xonik/xm8-panelized/ordered-march-1st-2025/AS3364 DG412 bus mixer v1.4-4-layer-brd.md

# AS3364 DG412 bus mixer v1.4-4-layer

### Board top
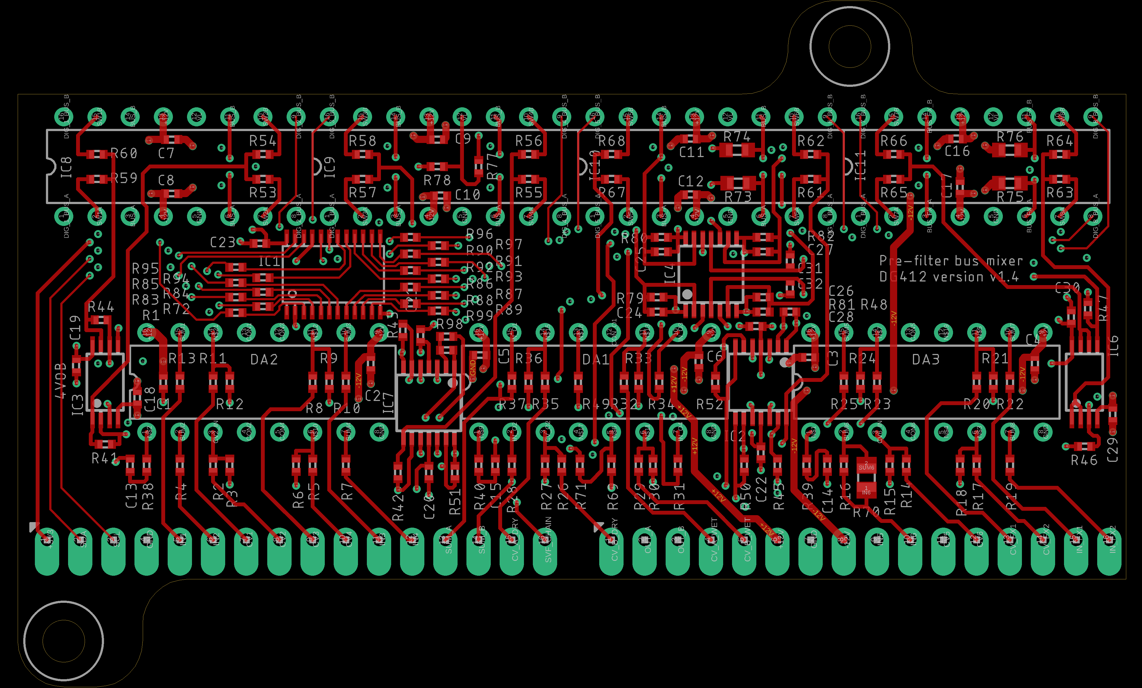
[picture p1: ordered-march-1st-2025/AS3364 DG412 bus mixer v1.4-4-layer-brd-top.png]
Top side

### Board bottom
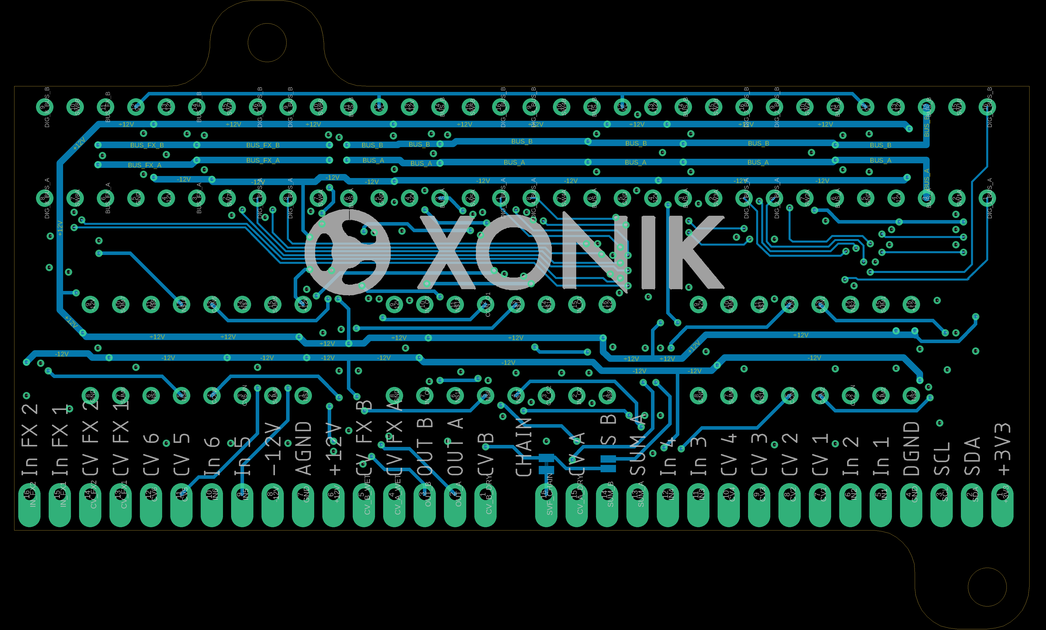
[picture p2: ordered-march-1st-2025/AS3364 DG412 bus mixer v1.4-4-layer-brd-bottom.png]
Bottom side
