xonik/xm8-panelized/ordered-2024/Filter boards jp6 v2.0 moog v1.2.1 - v1.0-brd.md

# Filter boards jp6 v2.0 moog v1.2.1 - v1.0

### Board top
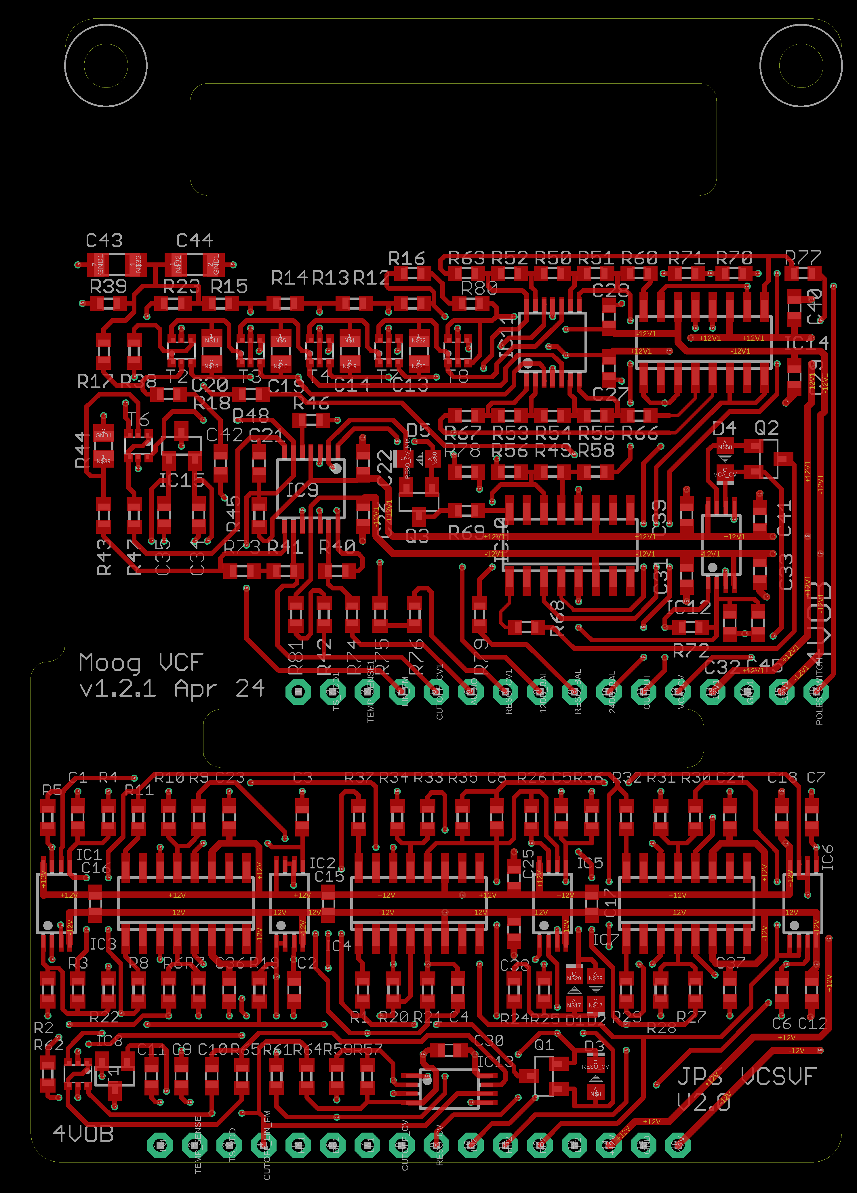
[picture p3: ordered-2024/Filter boards jp6 v2.0 moog v1.2.1 - v1.0-brd-top.png]
Top side

### Board bottom
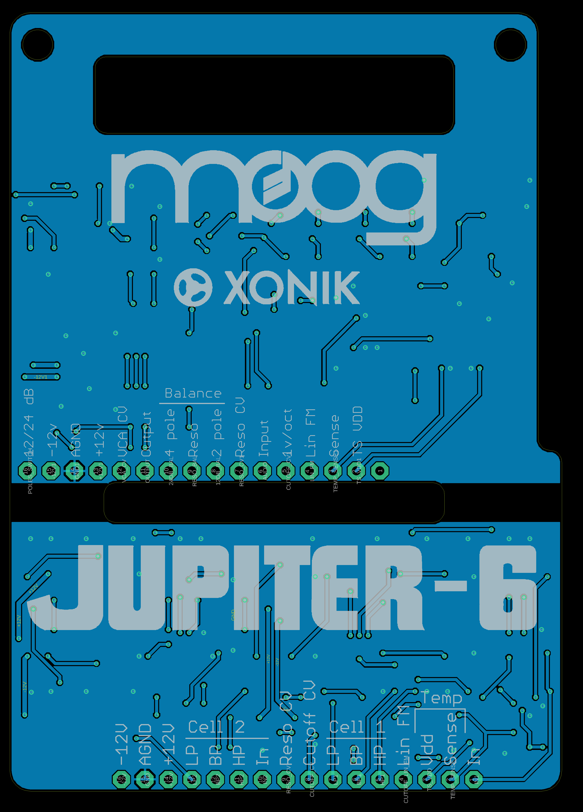
[picture p4: ordered-2024/Filter boards jp6 v2.0 moog v1.2.1 - v1.0-brd-bottom.png]
Bottom side
