xonik/xm8-panelized/ordered-2024/Waveshapers v2.2 for voice board v1.1.1 - v1.0-brd.md

# Waveshapers v2.2 for voice board v1.1.1 - v1.0

### Board top
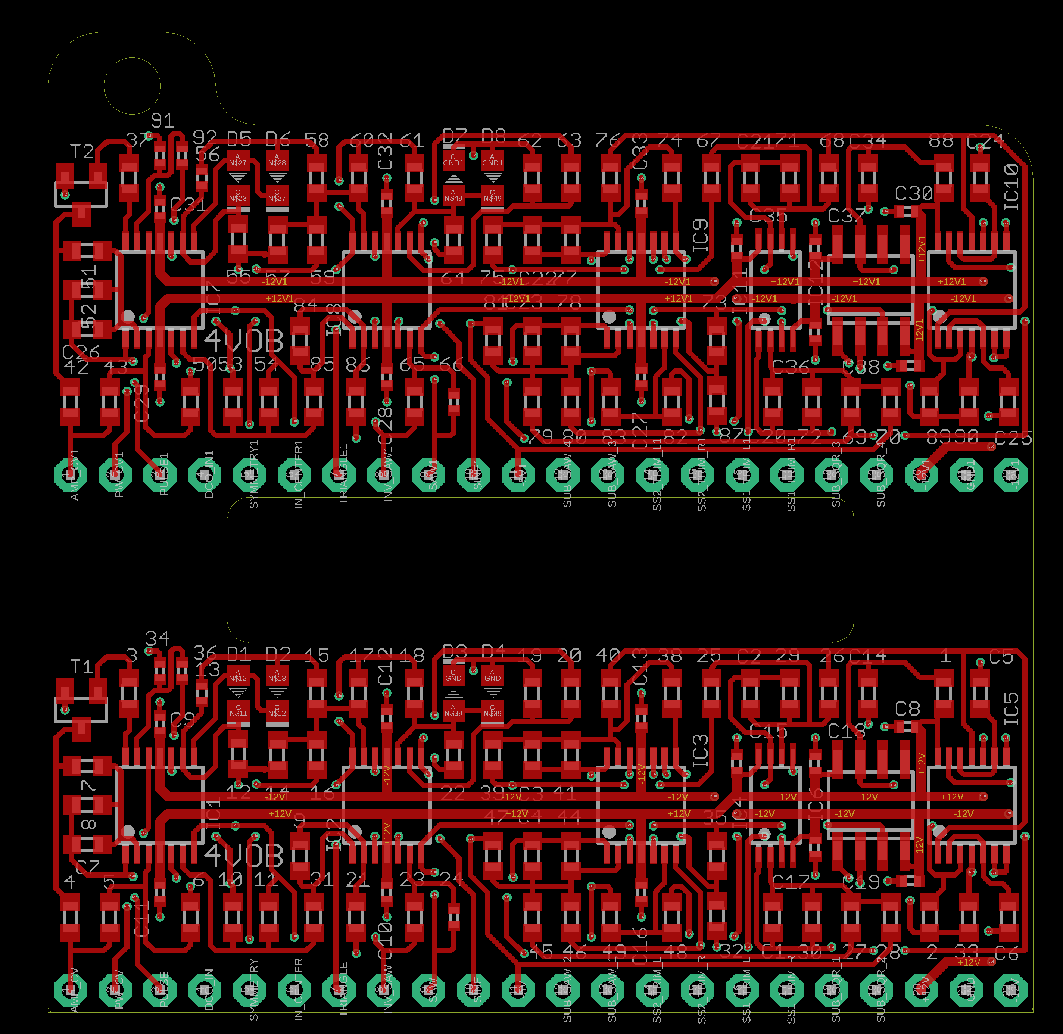
[picture p5: ordered-2024/Waveshapers v2.2 for voice board v1.1.1 - v1.0-brd-top.png]
Top side

### Board bottom
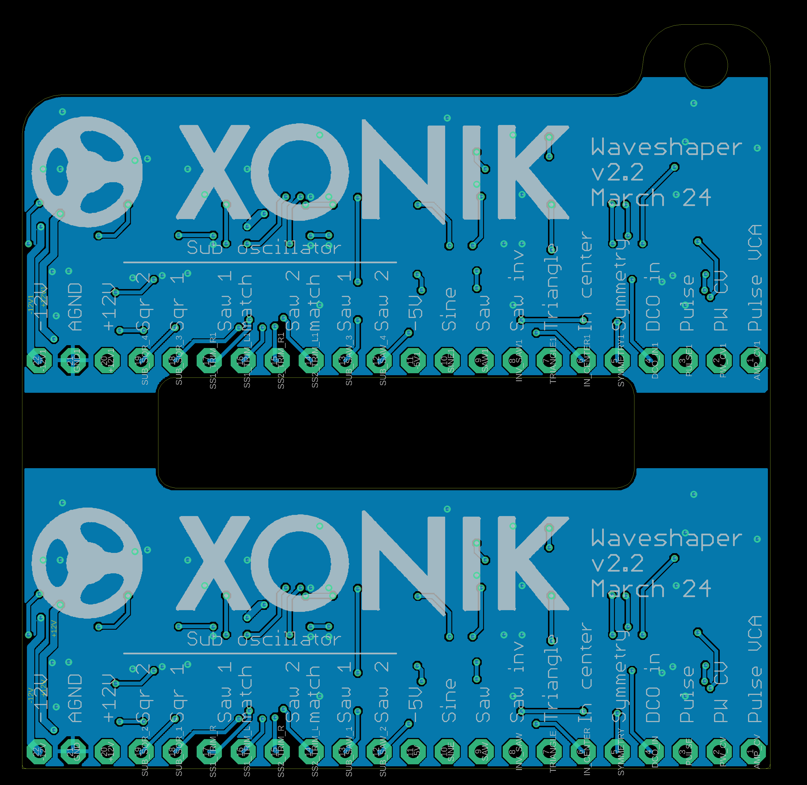
[picture p6: ordered-2024/Waveshapers v2.2 for voice board v1.1.1 - v1.0-brd-bottom.png]
Bottom side
