xonik/xm8-panelized/ordered-march-1st-2025/button_breakout_v1.0_top_bom_populated.csv

Comment | Designator | Footprint | LCSC Part #
MA08-2J | X1 X2 X3 X4 | MA08-2J | C5383108
CONN-IDC-10PS | IDC IDC1 IDC2 IDC3 | CONN-IDC10P-S | C429962
