xonik/xm8-panelized/ordered-march-1st-2025/AS3364 DG412 bus mixer v1.4-4-layer.brd

## EAGLE design ordered-march-1st-2025/AS3364 DG412 bus mixer v1.4-4-layer.brd (2025-03-01)

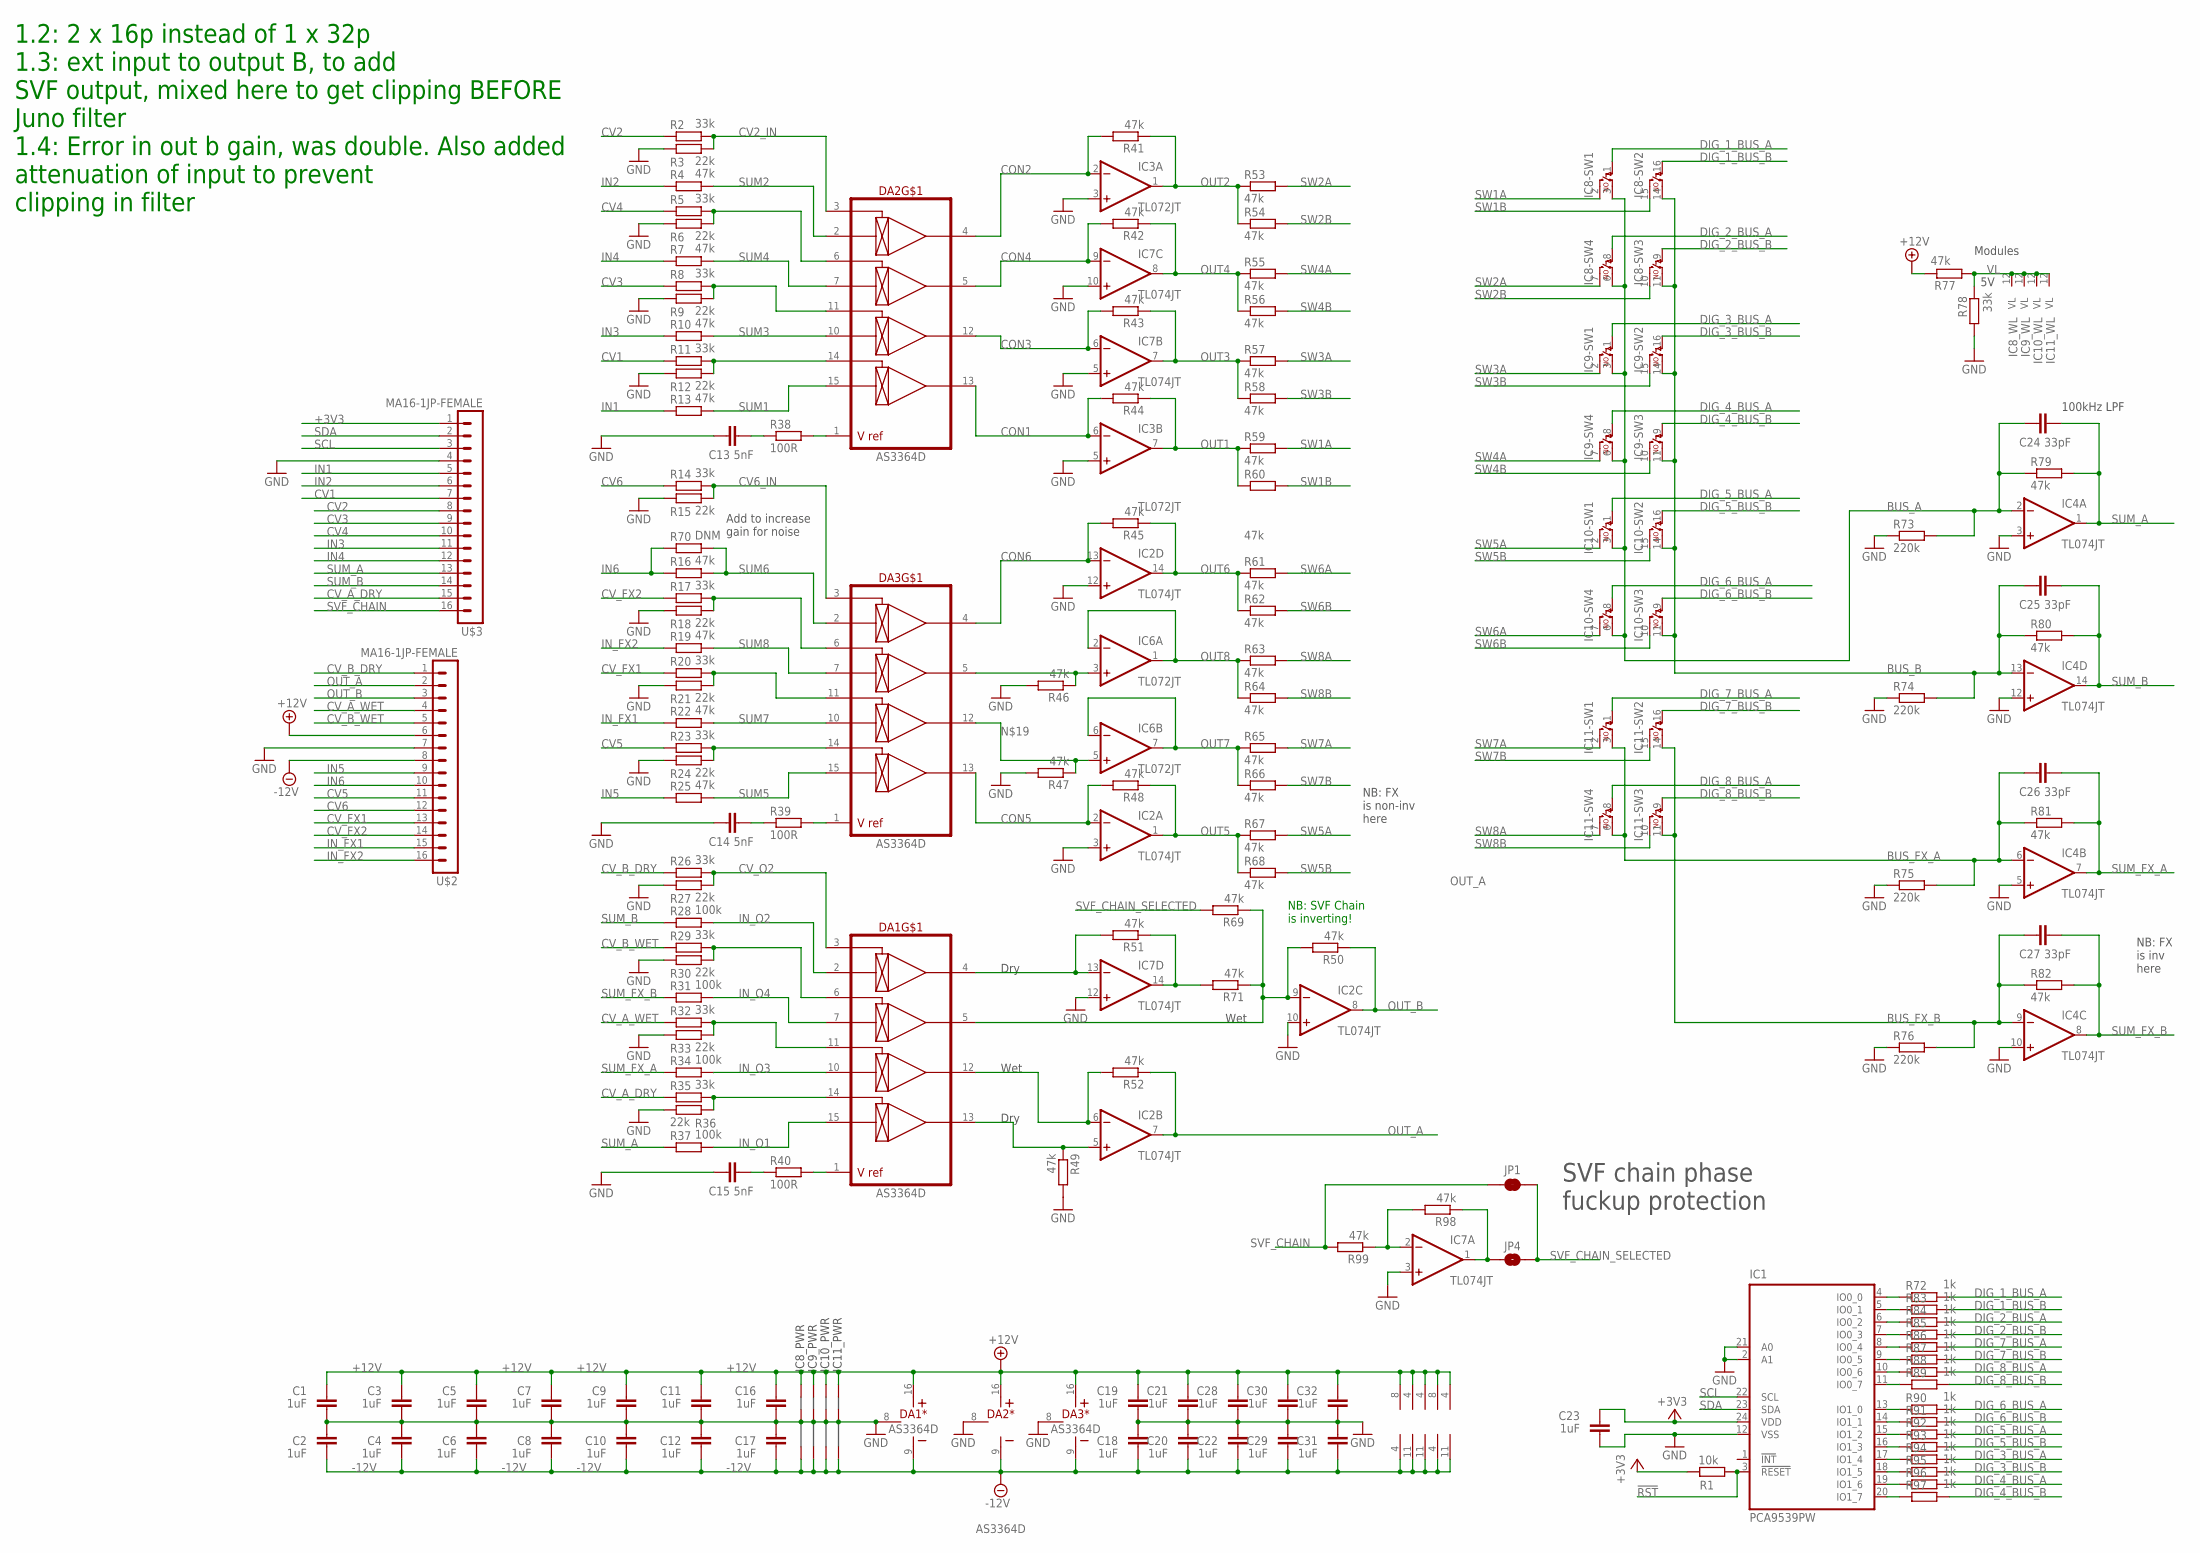
[picture p7: schematic AS3364 DG412 bus mixer v1.4-4-layer.sch]

Parts:
C1, C2, C3, C4, C5, C6, C7, C8, C9, C10, C11, C12, C16, C17, C18, C19, C20, C21, C22, C23, C28, C29, C30, C31, C32: 1uF; C0402-J
C13, C14, C15: 5nF; C0402-J
C24, C25, C26, C27: 33pF; C0402-J
DA1, DA2, DA3: AS3364D; DIL16J
IC1: PCA9539PW; TSSOP24J
IC2, IC4, IC7: TL074JT; TSSOP14J
IC3, IC6: TL072JT; TSSOP8J
IC8, IC9, IC10, IC11: DG412-J; DIL16J
JP1: JUMPER-SMT_2_NC_TRACE_SILK-DNM; SMT-JUMPER_2_NC_TRACE_SILK
JP4: JUMPER-SMT_2_NO_SILK-DNM; SMT-JUMPER_2_NO_SILK
R1: 10k; R0402
R2, R5, R8, R11, R14, R17, R20, R23, R26, R29, R32, R35, R78: 33k; R0402
R3, R6, R9, R12, R15, R18, R21, R24, R27, R30, R33, R36: 22k; R0402
R4, R7, R10, R13, R16, R19, R22, R25, R41, R42, R43, R44, R45, R46, R47, R48, R49, R50, R51, R52, R53, R54, R55, R56, R57, R58, R59, R60, R61, R62, R63, R64, R65, R66, R67, R68, R69, R71, R77, R79, R80, R81, R82, R98, R99: 47k; R0402
R28, R31, R34, R37: 100k; R0402
R38, R39, R40: 100R; R0402
R70: DNM; R0805
R72, R83, R84, R85, R86, R87, R88, R89, R90, R91, R92, R93, R94, R95, R96, R97: 1k; R0402
R73, R74, R75, R76: 220k; R0603
U$2, U$3: MA16-1JP-FEMALE; SIP-PIN16-1J

Connections:
!RST: IC1.3 (!RESET), R1.2
+3V3: C23.2, IC1.24 (VDD), R1.1, U$3.1
+12V: C1.2, C3.2, C5.2, C7.2, C9.2, C11.2, C16.2, C19.2, C21.2, C28.2, C30.2, C32.2, DA1.16 (V+), DA2.16 (V+), DA3.16 (V+), IC2.4 (V+), IC3.8 (V+), IC4.4 (V+), IC6.8 (V+), IC7.4 (V+), IC8.13 (+15V), IC9.13 (+15V), IC10.13 (+15V), IC11.13 (+15V), R77.1, U$2.6
-12V: C2.1, C4.1, C6.1, C8.1, C10.1, C12.1, C17.1, C18.1, C20.1, C22.1, C29.1, C31.1, DA1.9 (V-), DA2.9 (V-), DA3.9 (V-), IC2.11 (V-), IC3.4 (V-), IC4.11 (V-), IC6.4 (V-), IC7.11 (V-), IC8.4 (-15V), IC9.4 (-15V), IC10.4 (-15V), IC11.4 (-15V), U$2.8
BUS_A: C24.1, IC4.2 (-IN), IC8.3 (S), IC8.6 (S), IC9.3 (S), IC9.6 (S), IC10.3 (S), IC10.6 (S), R73.2, R79.1
BUS_B: C25.1, IC4.13 (-IN), IC8.11 (S), IC8.14 (S), IC9.11 (S), IC9.14 (S), IC10.11 (S), IC10.14 (S), R74.2, R80.1
BUS_FX_A: C26.1, IC4.6 (-IN), IC11.3 (S), IC11.6 (S), R75.2, R81.1
BUS_FX_B: C27.1, IC4.9 (-IN), IC11.11 (S), IC11.14 (S), R76.2, R82.1
CON1: DA2.13 (OUT4), IC3.6 (-IN), R44.2
CON2: DA2.4 (OUT1), IC3.2 (-IN), R41.2
CON3: DA2.12 (OUT3), IC7.6 (-IN), R43.2
CON4: DA2.5 (OUT2), IC7.9 (-IN), R42.2
CON5: DA3.13 (OUT4), IC2.2 (-IN), R48.2
CON6: DA3.4 (OUT1), IC2.13 (-IN), R45.2
CON_O1: DA1.12 (OUT3), IC2.6 (-IN), R52.2
CV1: R11.1, U$3.7
CV2: R2.1, U$3.8
CV2_IN: DA2.3 (CV1), R2.2, R3.2
CV3: R8.1, U$3.9
CV4: R5.1, U$3.10
CV5: R23.1, U$2.11
CV6: R14.1, U$2.12
CV6_IN: DA3.3 (CV1), R14.2, R15.2
CV_A_DRY: R35.1, U$3.15
CV_A_WET: R32.1, U$2.4
CV_B_DRY: R26.1, U$2.1
CV_B_WET: R29.1, U$2.5
CV_FX1: R20.1, U$2.13
CV_FX2: R17.1, U$2.14
CV_O2: DA1.3 (CV1), R26.2, R27.2
DIG_1_BUS_A: IC8.1 (C), R72.2
DIG_1_BUS_B: IC8.16 (C), R83.2
DIG_2_BUS_A: IC8.8 (C), R84.2
DIG_2_BUS_B: IC8.9 (C), R85.2
DIG_3_BUS_A: IC9.1 (C), R94.2
DIG_3_BUS_B: IC9.16 (C), R95.2
DIG_4_BUS_A: IC9.8 (C), R96.2
DIG_4_BUS_B: IC9.9 (C), R97.2
DIG_5_BUS_A: IC10.1 (C), R92.2
DIG_5_BUS_B: IC10.16 (C), R93.2
DIG_6_BUS_A: IC10.8 (C), R90.2
DIG_6_BUS_B: IC10.9 (C), R91.2
DIG_7_BUS_A: IC11.1 (C), R86.2
DIG_7_BUS_B: IC11.16 (C), R87.2
DIG_8_BUS_A: IC11.8 (C), R88.2
DIG_8_BUS_B: IC11.9 (C), R89.2
GND: C1.1, C2.2, C3.1, C4.2, C5.1, C6.2, C7.1, C8.2, C9.1, C10.2, C11.1, C12.2, C13.1, C14.1, C15.1, C16.1, C17.2, C18.2, C19.1, C20.2, C21.1, C22.2, C23.1, C28.1, C29.2, C30.1, C31.2, C32.1, DA1.8 (GND), DA2.8 (GND), DA3.8 (GND), IC1.2 (A1), IC1.12 (VSS), IC1.21 (A0), IC2.3 (+IN), IC2.10 (+IN), IC2.12 (+IN), IC3.3 (+IN), IC3.5 (+IN), IC4.3 (+IN), IC4.5 (+IN), IC4.10 (+IN), IC4.12 (+IN), IC7.3 (+IN), IC7.5 (+IN), IC7.10 (+IN), IC7.12 (+IN), IC8.5 (AGND), IC9.5 (AGND), IC10.5 (AGND), IC11.5 (AGND), R3.1, R6.1, R9.1, R12.1, R15.1, R18.1, R21.1, R24.1, R27.1, R30.1, R33.1, R36.1, R46.2, R47.2, R49.2, R73.1, R74.1, R75.1, R76.1, R78.2, U$2.7, U$3.4
IN1: R13.1, U$3.5
IN2: R4.1, U$3.6
IN3: R10.1, U$3.11
IN4: R7.1, U$3.12
IN5: R25.1, U$2.9
IN6: R16.1, R70.1, U$2.10
IN_FX1: R22.1, U$2.15
IN_FX2: R19.1, U$2.16
IN_O1: DA1.15 (IN4), R37.2
IN_O2: DA1.2 (IN1), R28.2
IN_O3: DA1.10 (IN3), R34.2
IN_O4: DA1.7 (IN2), R31.2
unnamed: DA3.1 (VREF), R39.2
unnamed: DA2.1 (VREF), R38.2
unnamed: DA3.6 (CV2), R17.2, R18.2
unnamed: DA3.5 (OUT2), IC6.3 (+IN), R46.1
unnamed: DA3.11 (CV3), R20.2, R21.2
unnamed: DA1.5 (OUT2), IC2.9 (-IN), R50.2, R69.1, R71.1
unnamed: DA3.14 (CV4), R23.2, R24.2
unnamed: C14.2, R39.1
unnamed: DA1.1 (VREF), R40.2
unnamed: DA2.6 (CV2), R5.2, R6.2
unnamed: DA1.6 (CV2), R29.2, R30.2
unnamed: DA2.11 (CV3), R8.2, R9.2
unnamed: DA1.11 (CV3), R32.2, R33.2
unnamed: C13.2, R38.1
unnamed: DA1.14 (CV4), R35.2, R36.2
unnamed: C15.2, R40.1
unnamed: DA1.4 (OUT1), IC7.13 (-IN), R51.2
unnamed: DA1.13 (OUT4), IC2.5 (+IN), R49.1
unnamed: DA3.12 (OUT3), IC6.5 (+IN), R47.1
unnamed: IC7.14 (OUT), R51.1, R71.2
unnamed: DA2.14 (CV4), R11.2, R12.2
unnamed: IC7.1 (OUT), JP4.1, R98.1
unnamed: IC1.4 (IO0_0), R72.1
unnamed: IC1.5 (IO0_1), R83.1
unnamed: IC1.6 (IO0_2), R84.1
unnamed: IC1.7 (IO0_3), R85.1
unnamed: IC1.8 (IO0_4), R86.1
unnamed: IC1.9 (IO0_5), R87.1
unnamed: IC1.10 (IO0_6), R88.1
unnamed: IC1.11 (IO0_7), R89.1
unnamed: IC1.13 (IO1_0), R90.1
unnamed: IC1.14 (IO1_1), R91.1
unnamed: IC1.15 (IO1_2), R92.1
unnamed: IC1.16 (IO1_3), R93.1
unnamed: IC1.17 (IO1_4), R94.1
unnamed: IC1.18 (IO1_5), R95.1
unnamed: IC1.19 (IO1_6), R96.1
unnamed: IC1.20 (IO1_7), R97.1
unnamed: IC7.2 (-IN), R98.2, R99.1
OUT1: IC3.7 (OUT), R44.1, R59.1, R60.1
OUT2: IC3.1 (OUT), R41.1, R53.1, R54.1
OUT3: IC7.7 (OUT), R43.1, R57.1, R58.1
OUT4: IC7.8 (OUT), R42.1, R55.1, R56.1
OUT5: IC2.1 (OUT), R48.1, R67.1, R68.1
OUT6: IC2.14 (OUT), R45.1, R61.1, R62.1
OUT7: IC6.6 (-IN), IC6.7 (OUT), R65.1, R66.1
OUT8: IC6.1 (OUT), IC6.2 (-IN), R63.1, R64.1
OUT_A: IC2.7 (OUT), R52.1, U$2.2
OUT_B: IC2.8 (OUT), R50.1, U$2.3
SCL: IC1.22 (SCL), U$3.3
SDA: IC1.23 (SDA), U$3.2
SUM1: DA2.15 (IN4), R13.2
SUM2: DA2.2 (IN1), R4.2
SUM3: DA2.10 (IN3), R10.2
SUM4: DA2.7 (IN2), R7.2
SUM5: DA3.15 (IN4), R25.2
SUM6: DA3.2 (IN1), R16.2, R70.2
SUM7: DA3.10 (IN3), R22.2
SUM8: DA3.7 (IN2), R19.2
SUM_A: C24.2, IC4.1 (OUT), R37.1, R79.2, U$3.13
SUM_B: C25.2, IC4.14 (OUT), R28.1, R80.2, U$3.14
SUM_FX_A: C26.2, IC4.7 (OUT), R34.1, R81.2
SUM_FX_B: C27.2, IC4.8 (OUT), R31.1, R82.2
SVF_CHAIN: JP1.1, R99.2, U$3.16
SVF_CHAIN_SELECTED: JP1.2, JP4.2, R69.2
SW1A: IC8.2 (D), R59.2
SW1B: IC8.15 (D), R60.2
SW2A: IC8.7 (D), R53.2
SW2B: IC8.10 (D), R54.2
SW3A: IC9.2 (D), R57.2
SW3B: IC9.15 (D), R58.2
SW4A: IC9.7 (D), R55.2
SW4B: IC9.10 (D), R56.2
SW5A: IC10.2 (D), R67.2
SW5B: IC10.15 (D), R68.2
SW6A: IC10.7 (D), R61.2
SW6B: IC10.10 (D), R62.2
SW7A: IC11.2 (D), R65.2
SW7B: IC11.15 (D), R66.2
SW8A: IC11.7 (D), R63.2
SW8B: IC11.10 (D), R64.2
VL: IC8.12 (VL), IC9.12 (VL), IC10.12 (VL), IC11.12 (VL), R77.2, R78.1

Notes on the sheet:
SVF chain phase fuckup protection
Modules
100kHz LPF
Wet
Dry
NB: FX is non-inv here
NB: FX is inv here
1.2: 2 x 16p instead of 1 x 32p 1.3: ext input to output B, to add SVF output, mixed here to get clipping BEFORE Juno filter 1.4: Error in out b gain, was double. Also added attenuation of input to prevent clipping in filter
NB: SVF Chain is inverting!
Add to increase gain for noise

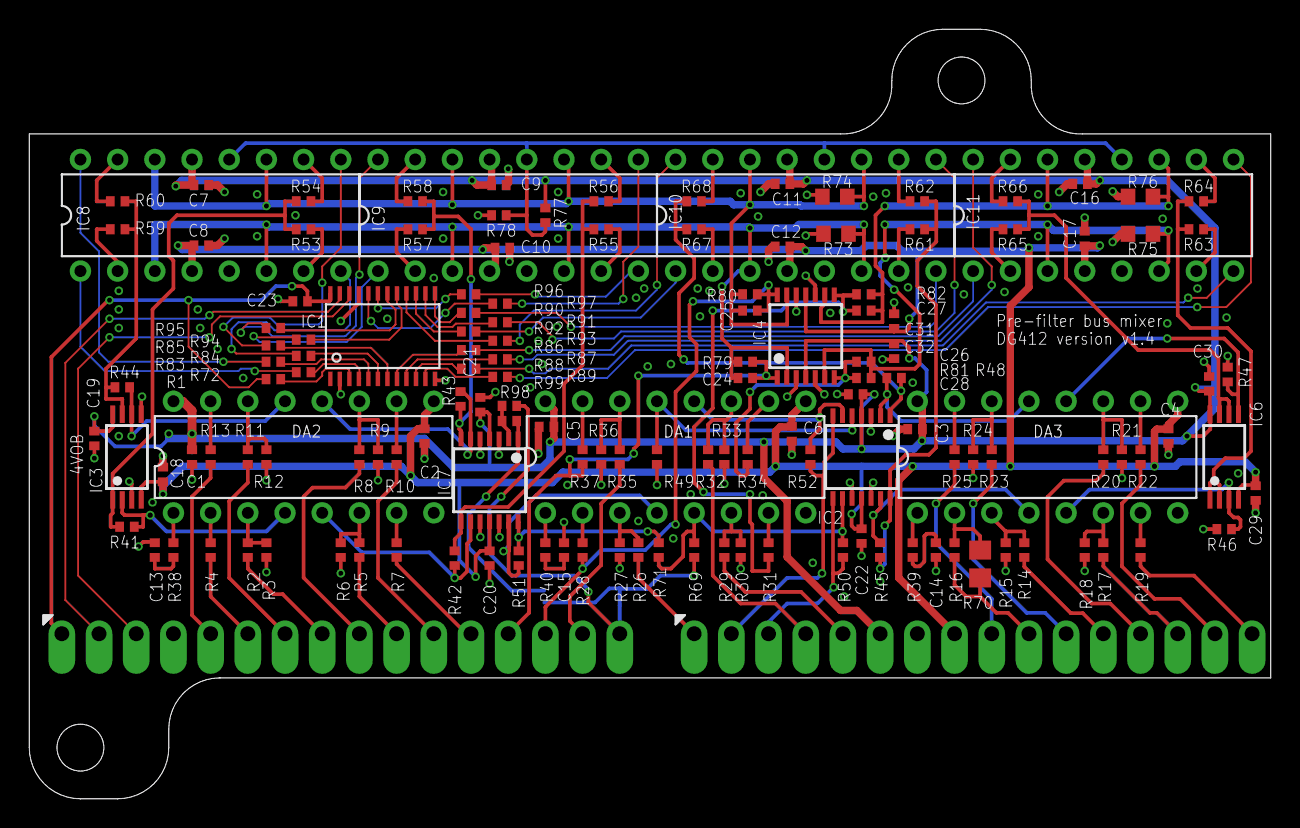
[picture p8: board AS3364 DG412 bus mixer v1.4-4-layer.brd from above]

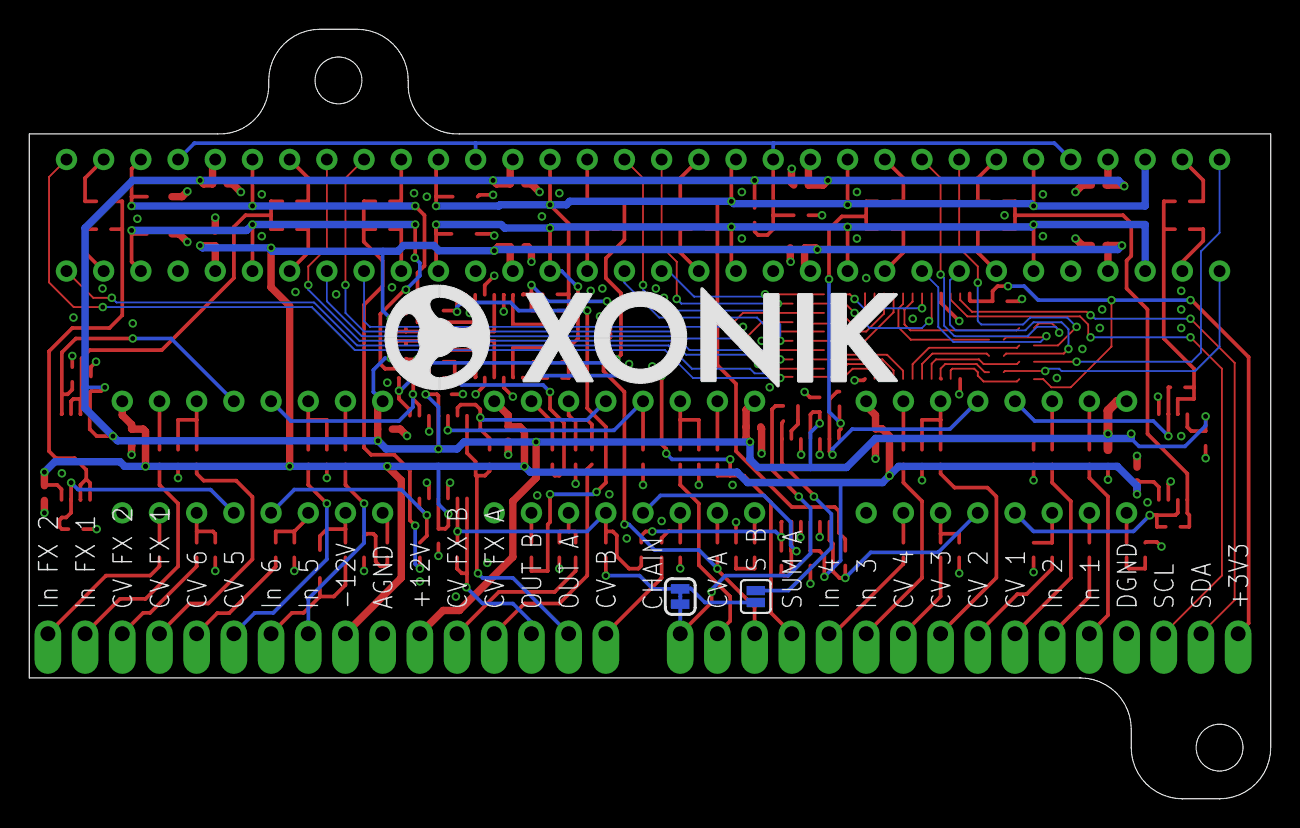
[picture p9: board AS3364 DG412 bus mixer v1.4-4-layer.brd from below]

Board: 4 copper layers, 84.8 x 52.5 mm, 149 parts (3 on the bottom side), 141 nets.

Other parts of the board:
U$1: XONIK_LOGO_35
