xonik/xm8-panelized/ordered-march-1st-2025/small-fix-cards-panelized.brd

## EAGLE design ordered-march-1st-2025/small-fix-cards-panelized.brd (2025-03-01)

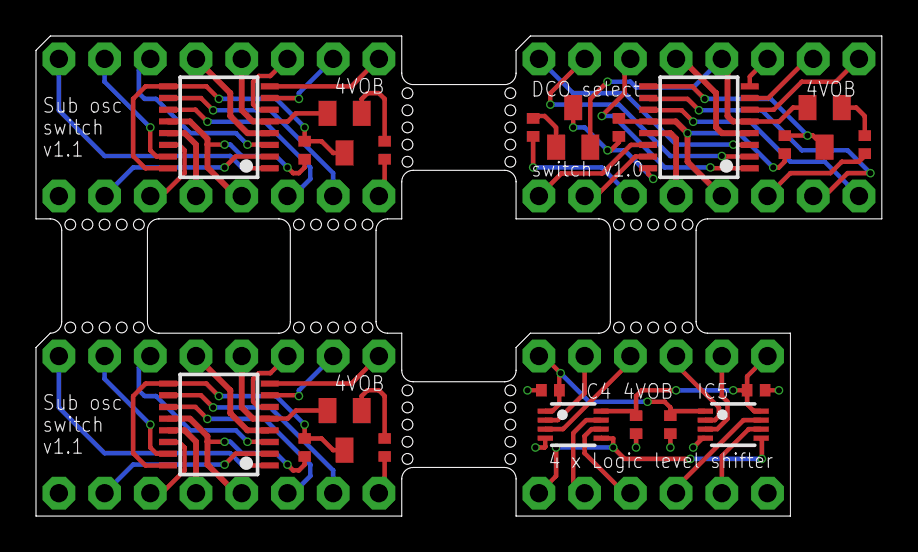
[picture p10: board small-fix-cards-panelized.brd from above]

Board: 2 copper layers, 47.0 x 26.7 mm, 29 parts (0 on the bottom side), 66 nets.

Parts:
C1, C2, C3, C4: 1uF; C0402-J
IC1, IC2, IC3: DG412-JT; TSSOP16J
IC4, IC5: SN74LVC2T45; VSSOP8J
R1, R2, R5, R6: 10k; R0402
R3, R4, R7, R8: 470R; R0402
T1, T2, T3, T4: 2n3904; SOT23-BEC
X1, X2, X3, X4, X5, X6: ROUND-IC-PIN; MA08N-1J
X7, X8: MA06-1JN; MA06N-1J

Connections:
1_A_SUB_WAVE: IC2.1, X1.1
1_A_SUB_WAVE1: IC1.1, X3.1
1_OSC_B_OUT: IC3.3, X5.1
2_SSA1A: IC2.15, X1.2
2_SSA1A1: IC1.15, X3.2
2_WAVE_B_OUT: IC3.2, X5.2
3_A_SUB_1: IC2.3, X1.3
3_A_SUB_2: IC1.3, X3.3
3_B_MODE: IC3.1, X5.3
6_A_MODE: IC3.8, X5.6
6_A_SUB_1: IC1.6, X3.6
6_A_SUB_2: IC2.6, X1.6
7_SSQ2A: IC2.7, X1.7
7_SSQ2A1: IC1.7, X3.7
7_WAVE_A_OUT: IC3.7, X5.7
8_A_SUB_WAVE: IC2.8, X1.8
8_A_SUB_WAVE1: IC1.8, X3.8
8_OSC_A_OUT: IC3.6, X5.8
9_A_SUB_WAVE: R2.1, X2.1
9_A_SUB_WAVE1: R1.1, X4.1
9_OSC_A_OUT: IC3.11, X6.1
10_SSA2A: IC2.10, X2.2
10_SSA2A1: IC1.10, X4.2
10_WF_A_OUT: IC3.10, X6.2
11_A_MODE: R6.1, X6.3
11_A_SUB_1: IC1.11, X4.3
11_A_SUB_2: IC2.11, X2.3
11_NOT_A_MODE: IC3.9, R8.1, T4.C
14_A_SUB_1: IC2.14, X2.6
14_A_SUB_2: IC1.14, X4.6
14_B_MODE: R5.1, X6.6
14_NOT_B_MODE: IC3.16, R7.1, T3.C
15_SSQ1A: IC2.2, X2.7
15_SSQ1A1: IC1.2, X4.7
15_WF_B_OUT: IC3.15, X6.7
16_OSC_B_OUT: IC3.14, X6.8
+3V3: C1.1, C3.1, IC4.1, IC5.1, X7.1
+5V: C2.1, C4.1, IC4.8, IC5.8, X7.6
A3: IC4.2, X7.2
A4: IC4.3, X7.3
A5: IC5.2, X7.4
A6: IC5.3, X7.5
B1: IC4.7, X8.5
B2: IC4.6, X8.4
B3: IC5.7, X8.3
B4: IC5.6, X8.2
DIR: IC4.5, IC5.5, X8.6
GND: IC2.5, T2.E, X1.5
GND1: IC1.5, T1.E, X3.5
GND2: IC3.5, T3.E, T4.E, X5.5
GND3: C1.2, C2.2, C3.2, C4.2, IC4.4, IC5.4, X8.1
unnamed: R1.2, T1.B
unnamed: R2.2, T2.B
unnamed: R5.2, T3.B
unnamed: R6.2, T4.B
NOT_A_SUB_WAVE: IC2.9, IC2.16, R4.1, T2.C
NOT_A_SUB_WAVE1: IC1.9, IC1.16, R3.1, T1.C
V+: IC2.13, X2.5
V+1: IC1.13, X4.5
V+2: IC3.13, X6.5
V-: IC2.4, X1.4
V-1: IC1.4, X3.4
V-2: IC3.4, X5.4
V_L: IC2.12, R4.2, X2.4
V_L1: IC1.12, R3.2, X4.4
V_L2: IC3.12, R7.2, R8.2, X6.4
