xonik/xm8-panelized/ordered-march-1st-2025/panel-controllers.brd

## EAGLE design ordered-march-1st-2025/panel-controllers.brd (2025-02-26)

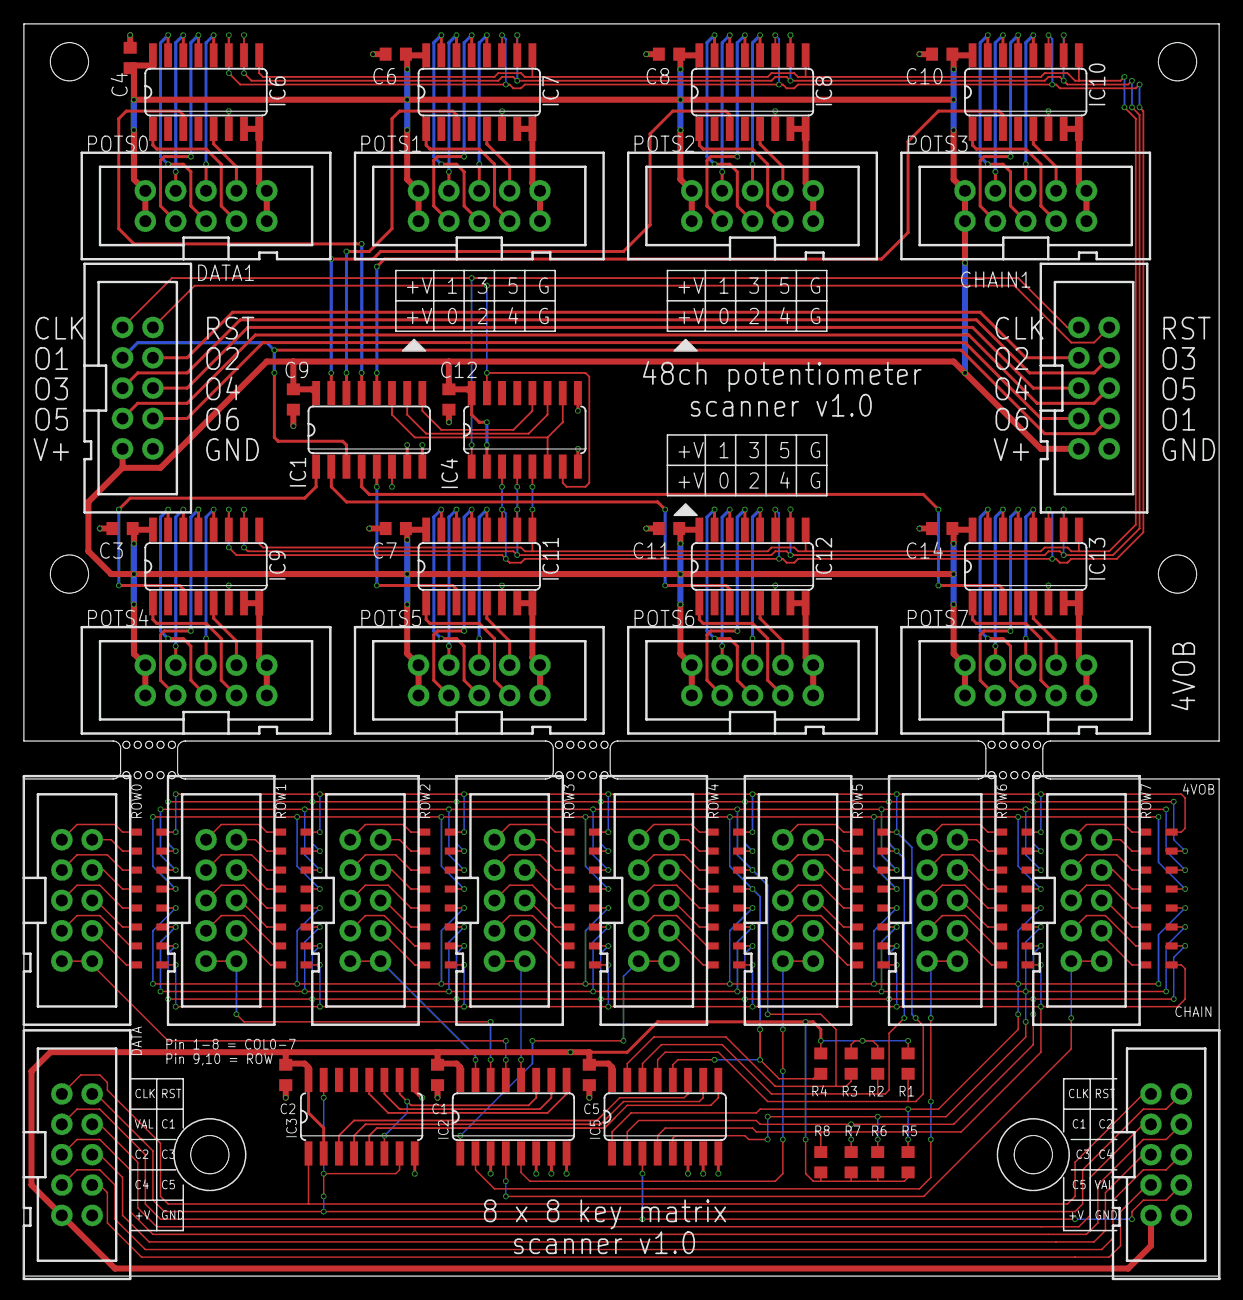
[picture p11: board panel-controllers.brd from above]

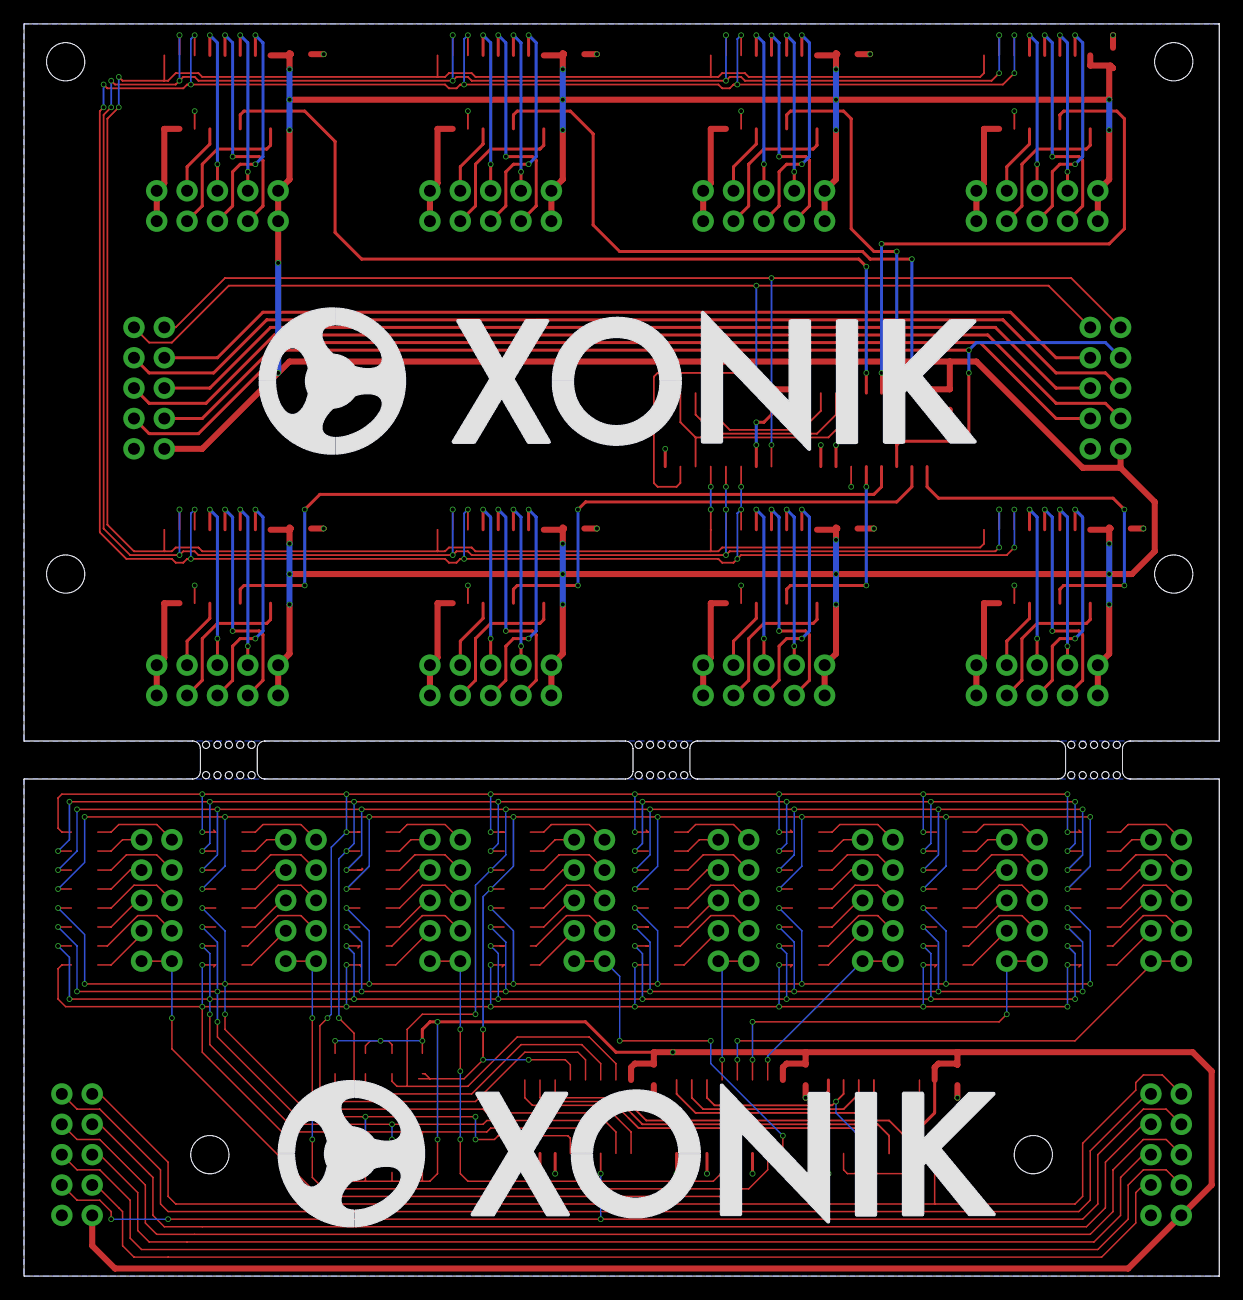
[picture p12: board panel-controllers.brd from below]

Board: 2 copper layers, 100.0 x 104.8 mm, 120 parts (2 on the bottom side), 168 nets.

Parts:
C1, C2, C3, C4, C5, C6, C7, C8, C9, C10, C11, C12, C14: 1uF; C0603-J
CHAIN, CHAIN1: CONN-IDC-10PS; CONN-IDC10P-S
D9, D10, D11, D12, D13, D14, D15, D16, D17, D18, D19, D20, D21, D22, D23, D24, D25, D26, D27, D28, D29, D30, D31, D32, D33, D34, D35, D36, D37, D38, D39, D40, D41, D42, D43, D44, D45, D46, D47, D48, D57, D58, D59, D60, D61, D62, D63, D64, D73, D74, D75, D76, D77, D78, D79, D80, D89, D90, D91, D92, D93, D94, D95, D96: 1N4148SOD323; SOD323J
DATA, DATA1: CONN-IDC-10PS; CONN-IDC10P-S
IC1, IC2, IC5, IC6, IC7, IC8, IC9, IC10, IC11, IC12, IC13: 4051D; SO16
IC3, IC4: 4520D; SO16
POTS0, POTS1, POTS2, POTS3, POTS4, POTS5, POTS6, POTS7: CONN-IDC-10PS; CONN-IDC10P-S
R1, R2, R3, R4, R5, R6, R7, R8: 10k; R0603
ROW0, ROW1, ROW2, ROW3, ROW4, ROW5, ROW6, ROW7: CONN-IDC-10PS; CONN-IDC10P-S
U$1, U$2: XONIK_LOGO_60

Connections:
+5V: C1.1, C2.1, C5.1, CHAIN.9, DATA.9, IC2.16, IC3.2, IC3.16, IC5.16, R1.2, R2.2, R3.2, R4.2, R5.2, R6.2, R7.2, R8.2
+5V1: C3.1, C4.1, C6.1, C7.1, C8.1, C9.1, C10.1, C11.1, C12.1, C14.1, CHAIN1.9, DATA1.9, IC1.16, IC4.2, IC4.16, IC6.16, IC7.16, IC8.16, IC9.16, IC10.16, IC11.16, IC12.16, IC13.16, POTS0.1, POTS0.2, POTS1.1, POTS1.2, POTS2.1, POTS2.2, POTS3.1, POTS3.2, POTS4.1, POTS4.2, POTS5.1, POTS5.2, POTS6.1, POTS6.2, POTS7.1, POTS7.2
BUTTON_VALUE: CHAIN.8, DATA.3, IC5.3
BUTTON_VAL_CHAIN_1: CHAIN.3, DATA.4
BUTTON_VAL_CHAIN_2: CHAIN.4, DATA.5
BUTTON_VAL_CHAIN_3: CHAIN.5, DATA.6
BUTTON_VAL_CHAIN_4: CHAIN.6, DATA.7
BUTTON_VAL_CHAIN_5: CHAIN.7, DATA.8
CLK: CHAIN.1, DATA.1, IC3.1
CLK1: CHAIN1.1, DATA1.1, IC4.1
COL0: D9.2, D17.2, D25.2, D33.2, D41.2, D57.2, D73.2, D89.2, IC5.13, R1.1
COL1: D10.2, D18.2, D26.2, D34.2, D42.2, D58.2, D74.2, D90.2, IC5.14, R2.1
COL2: D11.2, D19.2, D27.2, D35.2, D43.2, D59.2, D75.2, D91.2, IC5.15, R3.1
COL3: D12.2, D20.2, D28.2, D36.2, D44.2, D60.2, D76.2, D92.2, IC5.12, R4.1
COL4: D13.2, D21.2, D29.2, D37.2, D45.2, D61.2, D77.2, D93.2, IC5.1, R5.1
COL5: D14.2, D22.2, D30.2, D38.2, D46.2, D62.2, D78.2, D94.2, IC5.5, R6.1
COL6: D15.2, D23.2, D31.2, D39.2, D47.2, D63.2, D79.2, D95.2, IC5.2, R7.1
COL7: D16.2, D24.2, D32.2, D40.2, D48.2, D64.2, D80.2, D96.2, IC5.4, R8.1
COL_A: IC3.3, IC5.11
COL_B: IC3.4, IC5.10
COL_C: IC3.5, IC5.9
GND: C1.2, C2.2, C5.2, CHAIN.10, DATA.10, IC2.3, IC2.6, IC2.7, IC2.8, IC3.8, IC3.9, IC5.6, IC5.7, IC5.8
GND1: C3.2, C4.2, C6.2, C7.2, C8.2, C9.2, C10.2, C11.2, C12.2, C14.2, CHAIN1.10, DATA1.10, IC1.6, IC1.7, IC1.8, IC4.8, IC4.9, IC6.6, IC6.7, IC6.8, IC7.6, IC7.7, IC7.8, IC8.6, IC8.7, IC8.8, IC9.6, IC9.7, IC9.8, IC10.6, IC10.7, IC10.8, IC11.6, IC11.7, IC11.8, IC12.6, IC12.7, IC12.8, IC13.6, IC13.7, IC13.8, POTS0.9, POTS0.10, POTS1.9, POTS1.10, POTS2.9, POTS2.10, POTS3.9, POTS3.10, POTS4.9, POTS4.10, POTS5.9, POTS5.10, POTS6.9, POTS6.10, POTS7.9, POTS7.10
unnamed: D9.1, ROW0.1
unnamed: D10.1, ROW0.2
unnamed: D11.1, ROW0.3
unnamed: D12.1, ROW0.4
unnamed: D13.1, ROW0.5
unnamed: D14.1, ROW0.6
unnamed: D15.1, ROW0.7
unnamed: D16.1, ROW0.8
unnamed: D17.1, ROW2.1
unnamed: D18.1, ROW2.2
unnamed: D19.1, ROW2.3
unnamed: D20.1, ROW2.4
unnamed: D21.1, ROW2.5
unnamed: D22.1, ROW2.6
unnamed: D23.1, ROW2.7
unnamed: D24.1, ROW2.8
unnamed: D25.1, ROW1.1
unnamed: D26.1, ROW1.2
unnamed: D27.1, ROW1.3
unnamed: D28.1, ROW1.4
unnamed: D29.1, ROW1.5
unnamed: D30.1, ROW1.6
unnamed: D31.1, ROW1.7
unnamed: D32.1, ROW1.8
unnamed: D33.1, ROW4.1
unnamed: D34.1, ROW4.2
unnamed: D35.1, ROW4.3
unnamed: D36.1, ROW4.4
unnamed: D37.1, ROW4.5
unnamed: D38.1, ROW4.6
unnamed: D39.1, ROW4.7
unnamed: D40.1, ROW4.8
unnamed: D41.1, ROW3.1
unnamed: D42.1, ROW3.2
unnamed: D43.1, ROW3.3
unnamed: D44.1, ROW3.4
unnamed: D45.1, ROW3.5
unnamed: D46.1, ROW3.6
unnamed: D47.1, ROW3.7
unnamed: D48.1, ROW3.8
unnamed: D57.1, ROW5.1
unnamed: D58.1, ROW5.2
unnamed: D59.1, ROW5.3
unnamed: D60.1, ROW5.4
unnamed: D61.1, ROW5.5
unnamed: D62.1, ROW5.6
unnamed: D63.1, ROW5.7
unnamed: D64.1, ROW5.8
unnamed: D73.1, ROW6.1
unnamed: D74.1, ROW6.2
unnamed: D75.1, ROW6.3
unnamed: D76.1, ROW6.4
unnamed: D77.1, ROW6.5
unnamed: D78.1, ROW6.6
unnamed: D79.1, ROW6.7
unnamed: D80.1, ROW6.8
unnamed: D89.1, ROW7.1
unnamed: D90.1, ROW7.2
unnamed: D91.1, ROW7.3
unnamed: D92.1, ROW7.4
unnamed: D93.1, ROW7.5
unnamed: D94.1, ROW7.6
unnamed: D95.1, ROW7.7
unnamed: D96.1, ROW7.8
POT0: IC6.13, POTS0.3
POT1: IC6.14, POTS0.4
POT2: IC6.15, POTS0.5
POT3: IC6.12, POTS0.6
POT4: IC6.1, POTS0.7
POT5: IC6.5, POTS0.8
POT6: IC7.13, POTS1.3
POT7: IC7.14, POTS1.4
POT8: IC7.15, POTS1.5
POT9: IC7.12, POTS1.6
POT10: IC7.1, POTS1.7
POT11: IC7.5, POTS1.8
POT12: IC8.13, POTS2.3
POT13: IC8.14, POTS2.4
POT14: IC8.15, POTS2.5
POT15: IC8.12, POTS2.6
POT16: IC8.1, POTS2.7
POT17: IC8.5, POTS2.8
POT18: IC10.13, POTS3.3
POT19: IC10.14, POTS3.4
POT20: IC10.15, POTS3.5
POT21: IC10.12, POTS3.6
POT22: IC10.1, POTS3.7
POT23: IC10.5, POTS3.8
POT24: IC9.13, POTS4.3
POT25: IC9.14, POTS4.4
POT26: IC9.15, POTS4.5
POT27: IC9.12, POTS4.6
POT28: IC9.1, POTS4.7
POT29: IC9.5, POTS4.8
POT30: IC11.13, POTS5.3
POT31: IC11.14, POTS5.4
POT32: IC11.15, POTS5.5
POT33: IC11.12, POTS5.6
POT34: IC11.1, POTS5.7
POT35: IC11.5, POTS5.8
POT36: IC12.13, POTS6.3
POT37: IC12.14, POTS6.4
POT38: IC12.15, POTS6.5
POT39: IC12.12, POTS6.6
POT40: IC12.1, POTS6.7
POT41: IC12.5, POTS6.8
POT42: IC13.13, POTS7.3
POT43: IC13.14, POTS7.4
POT44: IC13.15, POTS7.5
POT45: IC13.12, POTS7.6
POT46: IC13.1, POTS7.7
POT47: IC13.5, POTS7.8
POT_A: IC4.3, IC6.11, IC7.11, IC8.11, IC9.11, IC10.11, IC11.11, IC12.11, IC13.11
POT_B: IC4.4, IC6.10, IC7.10, IC8.10, IC9.10, IC10.10, IC11.10, IC12.10, IC13.10
POT_C: IC4.5, IC6.9, IC7.9, IC8.9, IC9.9, IC10.9, IC11.9, IC12.9, IC13.9
POT_VALUE: CHAIN1.8, DATA1.3, IC1.3
POT_VAL_CHAIN_1: CHAIN1.3, DATA1.4
POT_VAL_CHAIN_2: CHAIN1.4, DATA1.5
POT_VAL_CHAIN_3: CHAIN1.5, DATA1.6
POT_VAL_CHAIN_4: CHAIN1.6, DATA1.7
POT_VAL_CHAIN_5: CHAIN1.7, DATA1.8
RESET: CHAIN.2, DATA.2, IC3.7, IC3.15
RESET1: CHAIN1.2, DATA1.2, IC4.7, IC4.15
ROW0: IC2.13, ROW0.9, ROW0.10
ROW1: IC2.14, ROW1.9, ROW1.10
ROW2: IC2.15, ROW2.9, ROW2.10
ROW3: IC2.12, ROW3.9, ROW3.10
ROW4: IC2.1, ROW4.9, ROW4.10
ROW5: IC2.5, ROW5.9, ROW5.10
ROW6: IC2.2, ROW6.9, ROW6.10
ROW7: IC2.4, ROW7.9, ROW7.10
ROW8: IC1.13, IC6.3
ROW9: IC1.14, IC7.3
ROW10: IC1.15, IC8.3
ROW11: IC1.12, IC10.3
ROW12: IC1.1, IC9.3
ROW13: IC1.5, IC11.3
ROW14: IC1.2, IC12.3
ROW15: IC1.4, IC13.3
ROW_A: IC2.11, IC3.6, IC3.10
ROW_A1: IC1.11, IC4.6, IC4.10
ROW_B: IC2.10, IC3.11
ROW_B1: IC1.10, IC4.11
ROW_C: IC2.9, IC3.12
ROW_C1: IC1.9, IC4.12
