xonik/xm8-panelized/ordered-march-1st-2025/Xonik Waveshaper v2.3.brd

## EAGLE design ordered-march-1st-2025/Xonik Waveshaper v2.3.brd (2025-02-26)

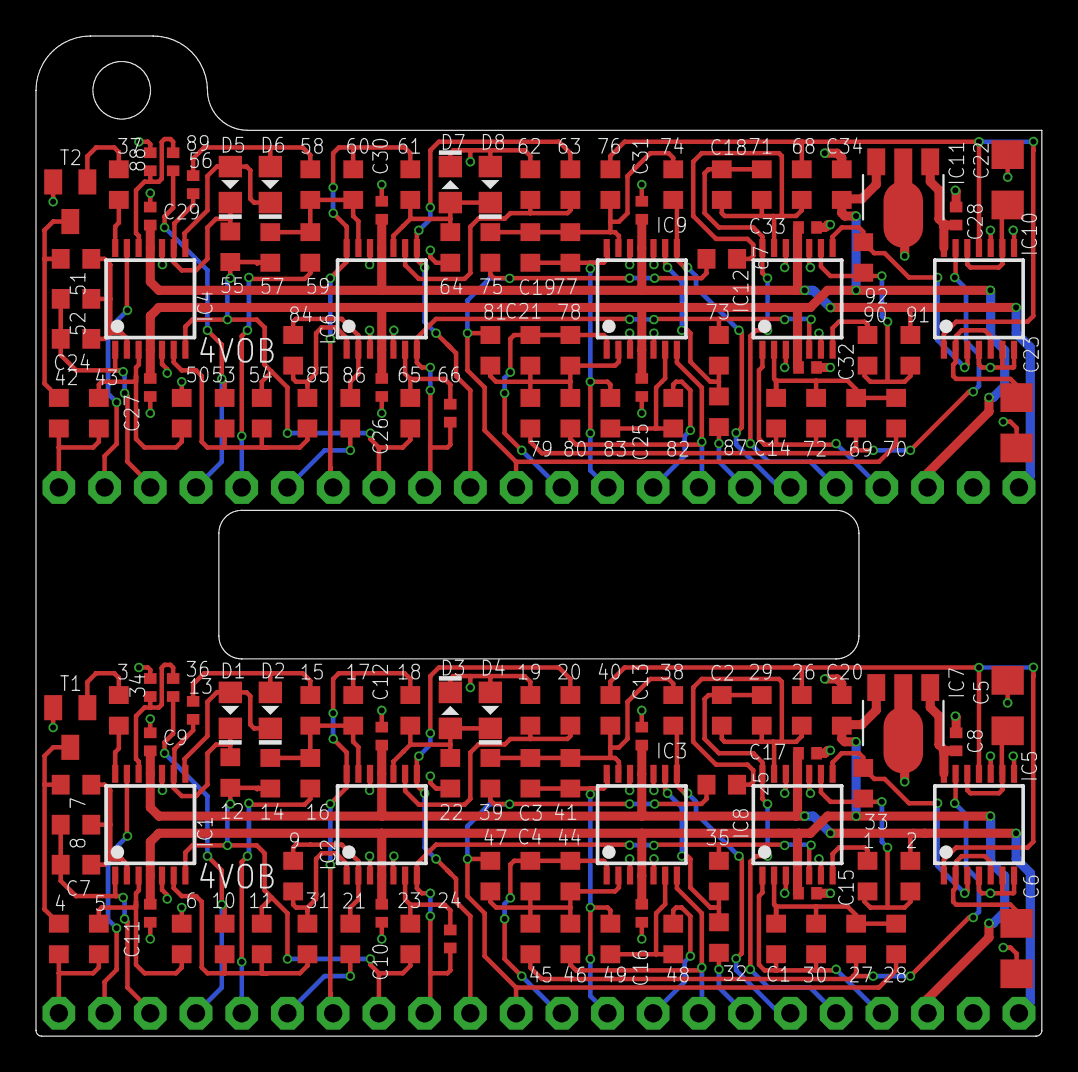
[picture p13: board Xonik Waveshaper v2.3.brd from above]

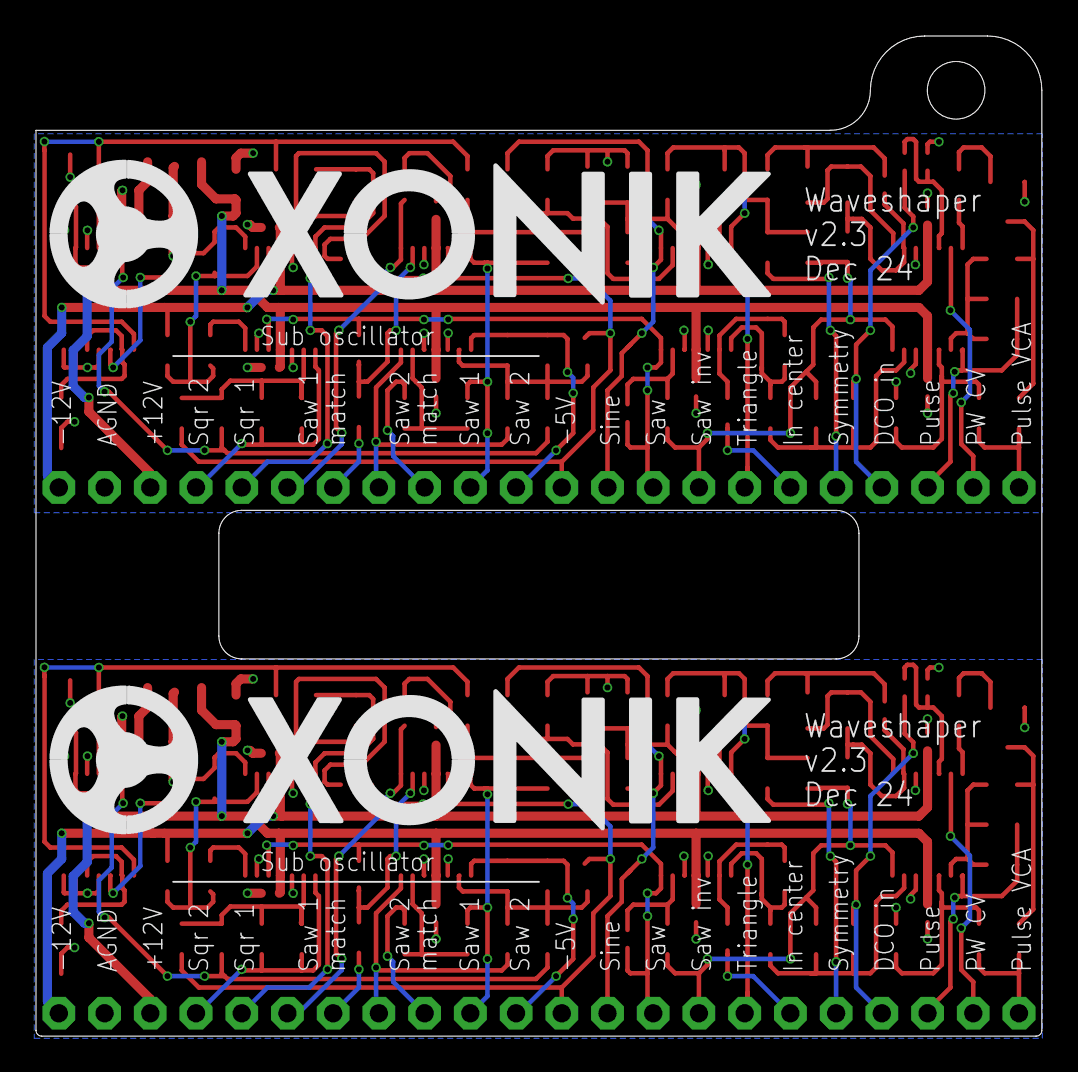
[picture p14: board Xonik Waveshaper v2.3.brd from below]

Board: 2 copper layers, 55.9 x 55.6 mm, 152 parts (2 on the bottom side), 104 nets.

Parts:
1, 2, 6, 7, 12, 14, 16, 23, 35, 39, 47, 49, 50, 51, 55, 57, 59, 65, 73, 75, 81, 83, 90, 91: 100k; R0603
3, 37: 68k; R0603
4, 42: 1k; R0603
5, 8, 17, 43, 52, 60: 200k; R0603
9, 84: 30k; R0603
10, 11, 31, 53, 54, 85: 27k; R0603
13, 24, 34, 36, 56, 66, 88, 89: 100k; R0402
15, 40, 45, 58, 76, 79: 50k; R0603
18, 61: 150k; R0603
19, 62: 1k2; R0603
20, 21, 63, 86: 15k; R0603
22, 64: 22k; R0603
25, 28, 29, 30, 33, 67, 70, 71, 72, 92: 20k; R0603
26, 27, 68, 69: 10k; R0603
32, 48, 82, 87: 33k; R0603
38, 41, 44, 46, 74, 77, 78, 80: 49.9k; R0603
C1, C2, C14, C18: 10pF; C0603-J
C3, C4, C19, C21: 30pF; C0603-J
C5, C6, C22, C23: 100nF; C1206
C7, C24: 3pF; C0603-J
C8, C9, C10, C11, C12, C13, C15, C16, C17, C25, C26, C27, C28, C29, C30, C31, C32, C33: 1uF; C0402-J
C20, C34: 0.33uF; C0603-J
D1, D2, D3, D4, D5, D6, D7, D8: 1N41480805; D0805-J
IC1, IC2, IC3, IC4, IC6, IC8, IC9, IC12: TL074JT; TSSOP14J
IC5, IC10: 4013T; TSSOP14J
IC7, IC11: 78L05F; SOT89
T1, T2: 2n3904; SOT23-BEC
U$1, U$2: XONIK_LOGO_40
X1, X2: MA22N-1J

Connections:
+5V: C8.2, IC5.14, IC7.1
+5V1: C28.2, IC10.14, IC11.1
+12V: C10.2, C11.2, C15.2, C16.2, C20.2, IC1.4, IC2.4, IC3.4, IC7.3, IC8.4, X1.20
+12V1: C25.2, C26.2, C27.2, C32.2, C34.2, IC4.4, IC6.4, IC9.4, IC11.3, IC12.4, X2.20
-5V: 25.1, 28.1, 39.2, 47.2, X1.11
-5V1: 67.1, 70.1, 75.2, 81.2, X2.11
-12V: 2.1, C9.1, C12.1, C13.1, C17.1, IC1.11, IC2.11, IC3.11, IC8.11, X1.22
-12V1: 91.1, C29.1, C30.1, C31.1, C33.1, IC4.11, IC6.11, IC9.11, IC12.11, X2.22
AMP_CV: 4.2, 5.2, X1.1
AMP_CV1: 42.2, 43.2, X2.1
DCO_IN: 10.1, 36.1, X1.4
DCO_IN1: 53.1, 89.1, X2.4
GND: 6.2, 19.2, 22.2, 34.2, C5.1, C6.1, C8.1, C9.2, C10.1, C11.1, C12.2, C13.2, C15.1, C16.1, C17.2, C20.1, D3.C, D4.A, IC1.5, IC1.10, IC2.3, IC2.5, IC2.12, IC3.3, IC3.5, IC3.10, IC3.12, IC5.4, IC5.6, IC5.7, IC5.8, IC5.10, IC7.2, IC7.2@1, IC8.3, IC8.6, IC8.10, IC8.12, T1.E, X1.21
GND1: 50.2, 62.2, 64.2, 88.2, C22.1, C23.1, C25.1, C26.1, C27.1, C28.1, C29.2, C30.2, C31.2, C32.1, C33.2, C34.1, D7.C, D8.A, IC4.5, IC4.10, IC6.3, IC6.5, IC6.12, IC9.3, IC9.5, IC9.10, IC9.12, IC10.4, IC10.6, IC10.7, IC10.8, IC10.10, IC11.2, IC11.2@1, IC12.3, IC12.6, IC12.10, IC12.12, T2.E, X2.21
INV_SAW: 11.2, 12.1, 14.1, 23.1, IC1.7, X1.8
INV_SAW1: 54.2, 55.1, 57.1, 65.1, IC4.7, X2.8
IN_CENTER: 21.1, X1.6
IN_CENTER1: 86.1, X2.6
unnamed: 9.1, 21.2, IC2.2
unnamed: 3.2, IC1.14
unnamed: 3.1, T1.B
unnamed: 4.1, 7.1, T1.C
unnamed: 5.1, 6.1, IC1.3
unnamed: 7.2, 8.1, C7.1, IC1.2
unnamed: 1.1, IC8.7
unnamed: 34.1, 36.2, IC1.12
unnamed: 1.2, 2.2, 33.1, IC8.9
unnamed: 10.2, 11.1, 31.2, IC1.6
unnamed: 12.2, 13.1, D1.C, IC1.9
unnamed: D1.A, D2.C, IC1.8
unnamed: 13.2, 15.2, D2.A
unnamed: 14.2, 15.1, 16.1, 17.2, IC2.13
unnamed: 23.2, 24.1, IC2.6
unnamed: 37.2, IC4.14
unnamed: 33.2, IC5.3, IC8.8
unnamed: 37.1, T2.B
unnamed: 25.2, 26.2, 29.1, C2.1, IC8.13
unnamed: 42.1, 51.1, T2.C
unnamed: 48.2, 49.2, IC3.6
unnamed: 27.2, 28.2, 30.1, C1.1, IC8.2
unnamed: 43.1, 50.1, IC4.3
unnamed: 32.1, 35.2, IC3.9
unnamed: 51.2, 52.1, C24.1, IC4.2
unnamed: 38.1, 39.1, 40.2, 41.1, C3.1, IC3.13
unnamed: 53.2, 54.1, 85.2, IC4.6
unnamed: 55.2, 56.1, D5.C, IC4.9
unnamed: 44.1, 45.1, 46.1, 47.1, C4.1, IC3.2
unnamed: D5.A, D6.C, IC4.8
unnamed: C6.2, IC5.2, IC5.5
unnamed: 26.1, 40.1, IC5.1, IC5.11
unnamed: 56.2, 58.2, D6.A
unnamed: C5.2, IC5.9, IC5.12
unnamed: 27.1, 45.2, IC5.13
unnamed: 19.1, 20.2, IC2.9
unnamed: 57.2, 58.1, 59.1, 60.2, IC6.13
unnamed: 65.2, 66.1, IC6.6
unnamed: 18.1, 22.1, D3.A, D4.C, IC2.10
unnamed: 67.2, 68.2, 71.1, C18.1, IC12.13
unnamed: 69.2, 70.2, 72.1, C14.1, IC12.2
unnamed: 9.2, 31.1, IC2.1
unnamed: 73.2, 87.1, IC9.9
unnamed: 74.1, 75.1, 76.2, 77.1, C19.1, IC9.13
unnamed: 82.2, 83.2, IC9.6
unnamed: 78.1, 79.1, 80.1, 81.1, C21.1, IC9.2
unnamed: C23.2, IC10.2, IC10.5
unnamed: 68.1, 76.1, IC10.1, IC10.11
unnamed: C22.2, IC10.9, IC10.12
unnamed: 69.1, 79.2, IC10.13
unnamed: 61.1, 64.1, D7.A, D8.C, IC6.10
unnamed: 62.1, 63.2, IC6.9
unnamed: 84.1, 86.2, IC6.2
unnamed: 84.2, 85.1, IC6.1
unnamed: 88.1, 89.2, IC4.12
unnamed: 90.2, 91.2, 92.1, IC12.9
unnamed: 92.2, IC10.3, IC12.8
unnamed: 90.1, IC12.7
PULSE: 8.2, C7.2, IC1.1, X1.3
PULSE1: 52.2, C24.2, IC4.1, X2.3
PW_CV: IC1.13, X1.2
PW_CV1: IC4.13, X2.2
SAW: 24.2, 35.1, IC2.7, IC8.5, X1.9
SAW1: 66.2, 73.1, IC6.7, IC12.5, X2.9
SINE: 20.1, IC2.8, X1.10
SINE1: 63.1, IC6.8, X2.10
SS1_TRIM_L: 32.2, X1.16
SS1_TRIM_L1: 87.2, X2.16
SS1_TRIM_R: 38.2, IC3.8, X1.17
SS1_TRIM_R1: 74.2, IC9.8, X2.17
SS2_TRIM_L: 48.1, X1.14
SS2_TRIM_L1: 82.1, X2.14
SS2_TRIM_R: 46.2, IC3.7, X1.15
SS2_TRIM_R1: 80.2, IC9.7, X2.15
SUB_SAW_1: 41.2, 49.1, C3.2, IC3.14, X1.13
SUB_SAW_2: 44.2, C4.2, IC3.1, X1.12
SUB_SAW_3: 77.2, 83.1, C19.2, IC9.14, X2.13
SUB_SAW_4: 78.2, C21.2, IC9.1, X2.12
SUB_SQR_1: 29.2, C2.2, IC8.14, X1.18
SUB_SQR_2: 30.2, C1.2, IC8.1, X1.19
SUB_SQR_3: 71.2, C18.2, IC12.14, X2.18
SUB_SQR_4: 72.2, C14.2, IC12.1, X2.19
SYMMETRY: 16.2, X1.5
SYMMETRY1: 59.2, X2.5
TRIANGLE: 17.1, 18.2, IC2.14, X1.7
TRIANGLE1: 60.1, 61.2, IC6.14, X2.7
