xonik/xm8-panelized/ordered-march-1st-2025/button_breakout_v1.0.brd

## EAGLE design ordered-march-1st-2025/button_breakout_v1.0.brd (2025-02-26)

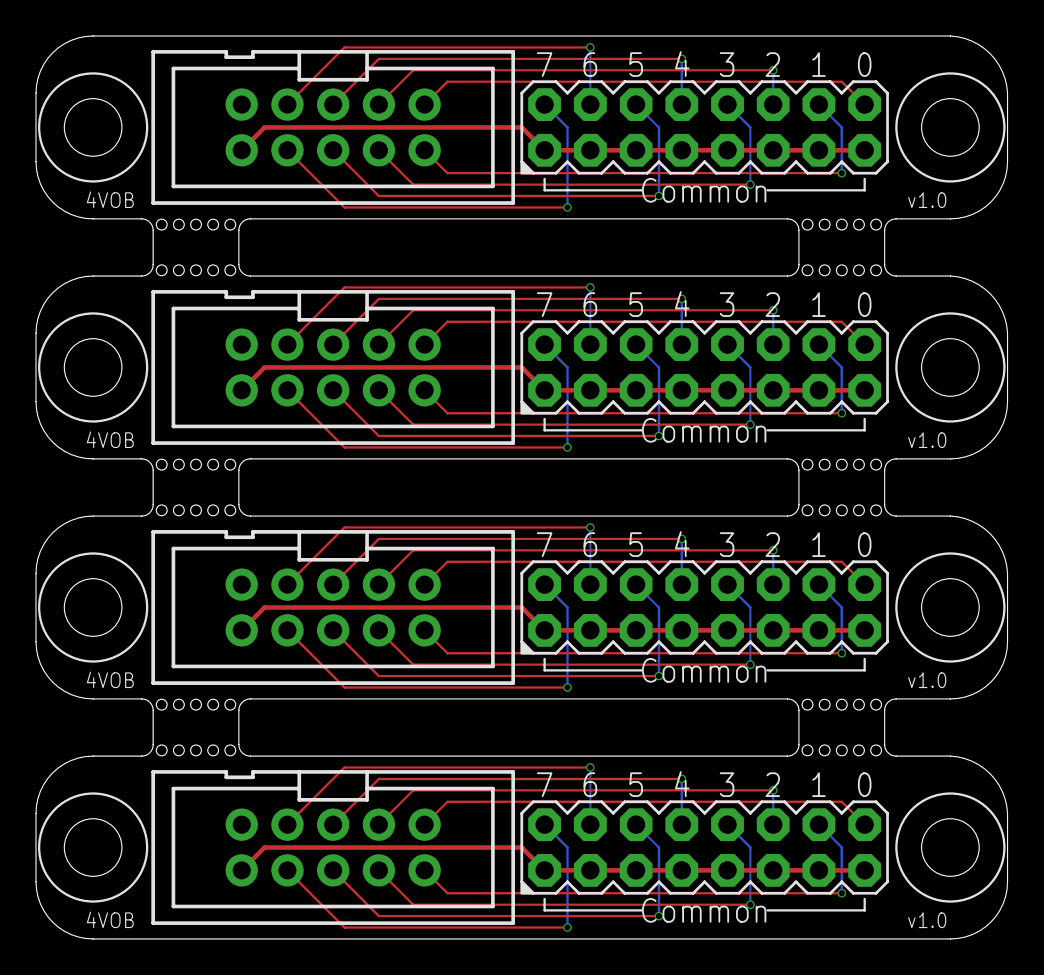
[picture p15: board button_breakout_v1.0.brd from above]

Board: 2 copper layers, 54.0 x 50.2 mm, 8 parts (0 on the bottom side), 36 nets.

Parts:
IDC, IDC1, IDC2, IDC3: CONN-IDC-10PS; CONN-IDC10P-S
X1, X2, X3, X4: MA08-2J

Connections:
COL0: IDC.1, X1.16
COL1: IDC.2, X1.14
COL2: IDC.3, X1.12
COL3: IDC.4, X1.10
COL4: IDC.5, X1.8
COL5: IDC.6, X1.6
COL6: IDC1.2, X2.14
COL7: IDC.8, X1.2
COL8: IDC1.3, X2.12
COL9: IDC1.4, X2.10
COL10: IDC1.5, X2.8
COL11: IDC1.6, X2.6
COL12: IDC1.8, X2.2
COL13: IDC1.1, X2.16
COL14: IDC1.7, X2.4
COL15: IDC2.2, X3.14
COL16: IDC.7, X1.4
COL17: IDC2.3, X3.12
COL18: IDC2.4, X3.10
COL19: IDC2.5, X3.8
COL20: IDC2.6, X3.6
COL21: IDC2.8, X3.2
COL22: IDC2.1, X3.16
COL23: IDC2.7, X3.4
COL24: IDC3.2, X4.14
COL25: IDC3.3, X4.12
COL26: IDC3.4, X4.10
COL27: IDC3.5, X4.8
COL28: IDC3.6, X4.6
COL29: IDC3.8, X4.2
COL30: IDC3.1, X4.16
COL31: IDC3.7, X4.4
ROW0: IDC.10, X1.1, X1.3, X1.5, X1.7, X1.9, X1.11, X1.13, X1.15
ROW1: IDC1.10, X2.1, X2.3, X2.5, X2.7, X2.9, X2.11, X2.13, X2.15
ROW2: IDC2.10, X3.1, X3.3, X3.5, X3.7, X3.9, X3.11, X3.13, X3.15
ROW3: IDC3.10, X4.1, X4.3, X4.5, X4.7, X4.9, X4.11, X4.13, X4.15
