xonik/xm8-panelized/ordered-2024/Filter boards jp6 v2.0 moog v1.2.1 - v1.0.brd

## EAGLE design ordered-2024/Filter boards jp6 v2.0 moog v1.2.1 - v1.0.brd (2025-02-26)

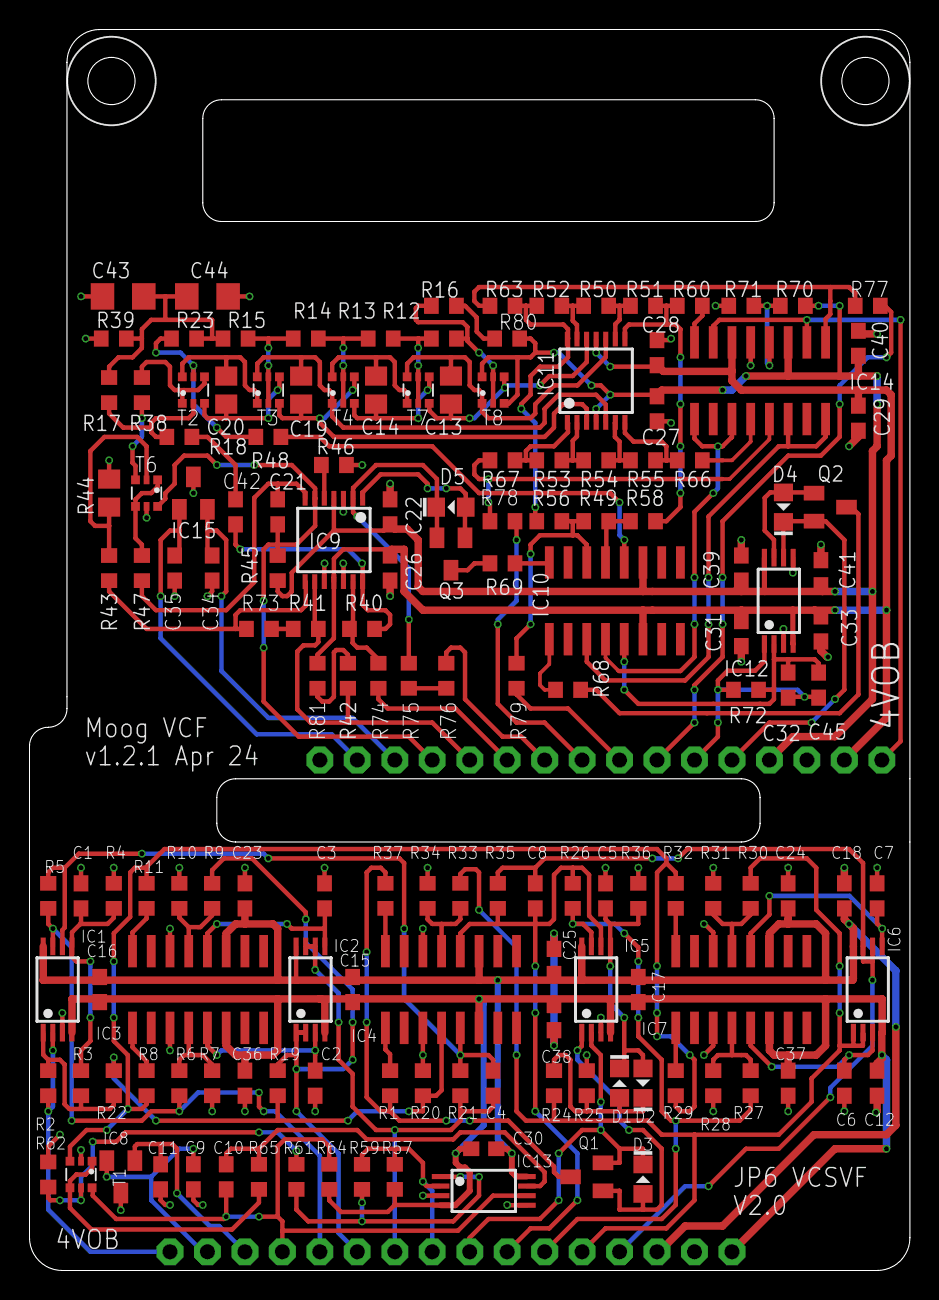
[picture p16: board Filter boards jp6 v2.0 moog v1.2.1 - v1.0.brd from above]

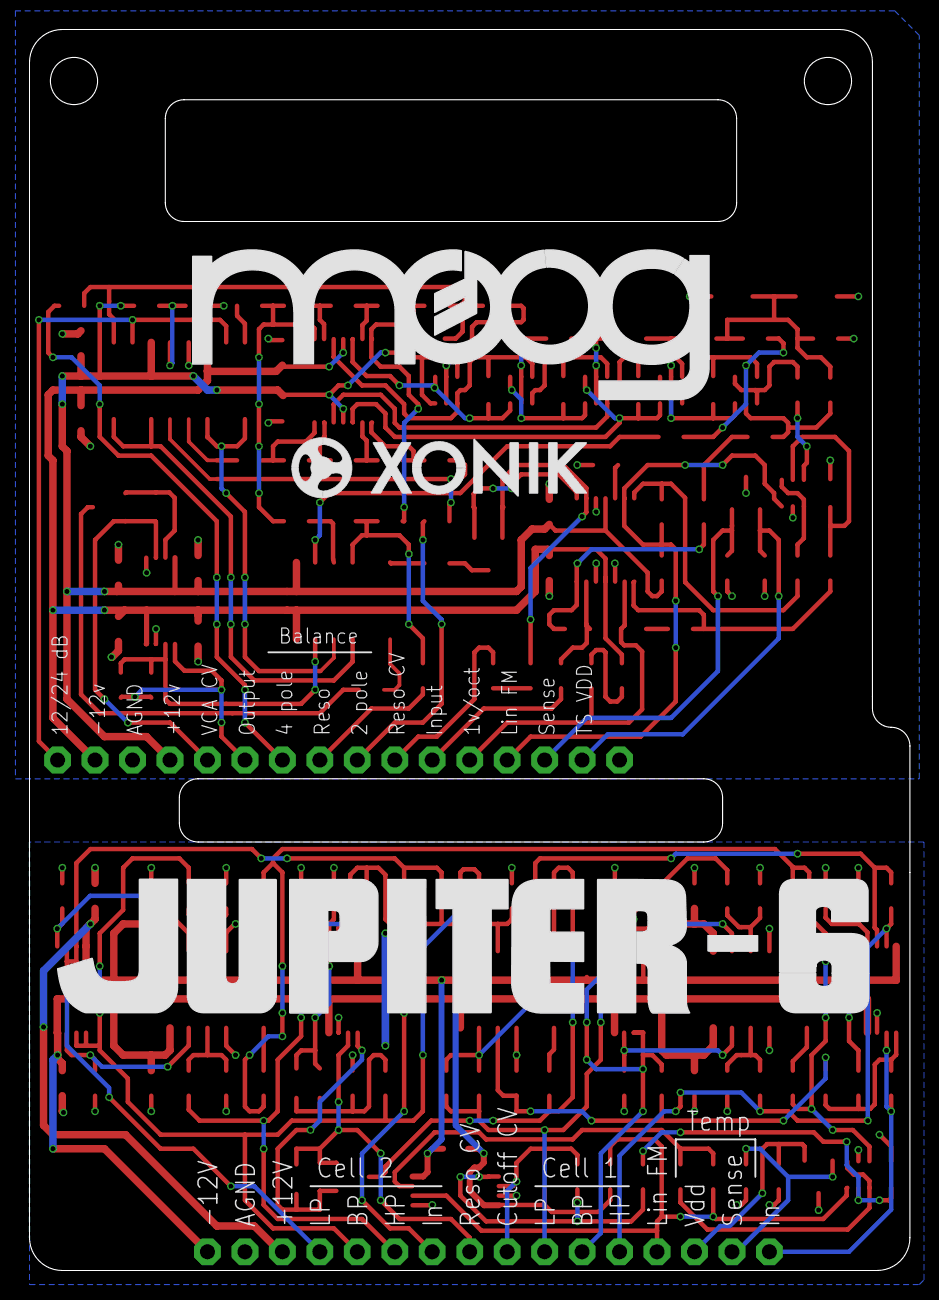
[picture p17: board Filter boards jp6 v2.0 moog v1.2.1 - v1.0.brd from below]

Board: 2 copper layers, 59.7 x 84.1 mm, 161 parts (3 on the bottom side), 114 nets.

Parts:
C1, C5, C32, C45: 33p; C0603
C2, C3, C6, C7: 330p; C0603
C4, C8: 5p; C0603
C9, C11, C12, C15, C16, C17, C18, C22, C23, C24, C25, C26, C27, C28, C29, C30, C31, C33, C34, C35, C36, C37, C38, C39, C40, C41, C42: 1uF; C0603
C10: 47p; C0603
C13, C14, C19, C20: 22n; C0805
C21: 100p; C0603
C43, C44: 100uF/6.3V; C1206
D1, D2, D3, D4, D5: 1N41480805; D0805-J
IC1, IC2, IC5, IC6, IC12, IC13: TL072JT; TSSOP8J
IC3, IC4, IC7, IC10: LM13700SL; SO16-NARROW-J
IC8, IC15: MCP9700TT; SOT23J
IC9, IC11: TL074JT; TSSOP14J
IC14: DG403C-JSL; SO16-NARROW-J
Q1, Q2, Q3: MMBT3906LT1SMD; SOT23-BEC
R1, R25, R37, R40, R47, R51, R52, R53, R55, R68, R69: 10k; R0603
R2, R22, R36: 33k; R0603
R3, R24: 47k; R0603
R4, R8, R11, R29, R32: 8k2; R0603
R5, R21, R26, R35, R41, R59, R74: 100k; R0603
R6, R9, R19, R27, R30, R33: 68k; R0603
R7, R10, R20, R28, R31, R34, R62: 560R; R0603
R12, R13, R14, R15, R17, R23, R38, R39, R48: 1k; R0603
R16, R73: 5k6; R0603
R18, R42: 120k; R0603
R43: 56k; R0603
R44: 1k; R0805
R45: 820k; R0603
R46: 1M; R0603
R49: 51R; R0603
R50, R54: 5k1; R0603
R56, R58: 200R; R0603
R57: 330k; R0603
R60, R63, R66, R67: 100R; R0603
R61, R81: 15k; R0603
R64: 1M2; R0603
R65: 1k5; R0603
R70: 105k; R0603
R71: 75k; R0603
R72: 30k; R0603
R75: 3k3; R0603
R76: 18k; R0603
R77, R78: 3k9; R0603
R79: 22k; R0603
R80: 330R; R0603
T1: BC857BS; SOT363J
T2, T3, T4, T6, T7, T8: BC847BS; SOT363J
U$2: JP6_55
U$3, U$6: MA16-1JN; MA16N-1J
U$4: MOOG_35
U$5: XONIK_LOGO_20

Connections:
2P+: IC14.5, R67.1, R78.1
2P-: IC14.4, R66.1
4P+: IC14.9, R63.1, R77.1
4P-: IC14.16, R60.1
12DB_BAL: R78.2, U$6.8
24DB_BAL: R77.2, U$6.10
+12V: C15.1, C16.1, C17.1, C18.1, C23.1, C24.1, C25.1, C30.1, IC1.8, IC2.8, IC3.11, IC4.11, IC5.8, IC6.8, IC7.11, IC13.8, U$3.14
+12V1: C22.2, C27.2, C39.2, C40.2, C41.2, IC9.4, IC10.11, IC11.4, IC12.8, IC14.11, R45.2, R70.1, R80.2, T8.3, T8.6, U$6.13
-12V: C12.2, C15.2, C16.2, C17.2, C30.2, C36.2, C37.2, C38.2, IC1.4, IC2.4, IC3.6, IC4.6, IC5.4, IC6.4, IC7.6, IC13.4, R57.2, R64.2, U$3.16
-12V1: C26.1, C28.1, C29.1, C31.1, C33.1, IC9.11, IC10.6, IC11.11, IC12.4, IC14.14, R81.2, U$6.15
AUDIO: R74.2, U$6.6
AUDIO_SUM: IC9.13, R40.2, R74.1
BP1: IC2.1, IC2.2, R9.1, R19.1, U$3.6
BP2: IC6.1, IC6.2, R24.1, R30.1, R33.1, U$3.12
CUTOFF_CV: IC13.2, R57.1, R59.2, U$3.8
CUTOFF_CV1: IC9.9, R41.2, R42.1, U$6.5
CUTOFF_IABC: R8.2, R11.1, R29.2, R32.1, T1.3
CUTOFF_LIN_FM: C10.1, IC13.6, R64.1, T1.6, U$3.4
GND: C1.2, C2.2, C3.2, C5.2, C6.2, C7.2, C9.1, C11.1, C12.1, C18.2, C23.2, C24.2, C25.2, C36.1, C37.1, C38.1, IC1.3, IC3.3, IC3.14, IC4.3, IC4.14, IC5.3, IC7.3, IC7.14, IC8.3, IC13.3, IC13.5, R4.1, R7.2, R10.1, R20.2, R25.1, R28.2, R31.1, R34.2, R36.1, R62.2, T1.2, U$3.15
GND1: C22.1, C26.2, C27.1, C28.2, C29.2, C31.2, C33.2, C34.1, C35.1, C39.1, C40.1, C41.1, C43.2, C44.2, IC9.3, IC9.10, IC9.12, IC12.3, IC12.5, IC14.13, IC15.3, R39.1, R44.2, R46.2, R71.2, T6.5, U$6.14
HP1: IC1.7, R5.2, R6.2, U$3.5
HP2: IC5.7, R26.2, R27.2, U$3.11
IN1: IC1.2, R2.1, U$3.1
IN2: C8.2, IC4.12, IC5.6, R26.1, R35.2, U$3.10
LIN_FM: C21.1, IC9.6, R45.1, T6.6, U$6.4
LP1: C4.1, IC2.6, IC2.7, R21.1, U$3.7
LP2: C8.1, IC6.6, IC6.7, R35.1, U$3.13
unnamed: C14.1, T4.6, T7.1
unnamed: IC3.1, R8.1
unnamed: IC3.16, R11.2
unnamed: IC4.1, R1.2
unnamed: C19.1, IC11.5, T3.6, T4.1
unnamed: C1.1, IC1.5, R3.2, R4.2
unnamed: C4.2, IC1.6, IC4.5, R5.1, R21.2
unnamed: D3.A, IC5.1, Q1.B
unnamed: IC3.4, R6.1, R7.1
unnamed: IC7.1, R29.1
unnamed: C20.1, T2.6, T3.1
unnamed: C2.1, IC2.3, IC3.5
unnamed: IC7.16, R32.2
unnamed: IC3.13, R9.2, R10.2
unnamed: C3.1, IC2.5, IC3.12
unnamed: C19.2, IC11.3, T3.3, T4.4
unnamed: D1.A, D2.C, R24.2, R25.2
unnamed: C20.2, T2.3, T3.4
unnamed: C14.2, T4.3, T7.4
unnamed: C13.2, IC11.12, T7.3, T8.4
unnamed: IC7.4, R27.1, R28.1
unnamed: C13.1, IC11.10, T7.6, T8.1
unnamed: C6.1, IC6.3, IC7.5
unnamed: IC7.13, R30.2, R31.2
unnamed: C7.1, IC6.5, IC7.12
unnamed: R14.1, R15.2, T3.2, T3.5
unnamed: IC4.13, R33.2, R34.1
unnamed: IC4.16, R37.2
unnamed: C5.1, D1.C, D2.A, IC5.5, R36.2
unnamed: R12.1, R13.2, T7.2, T7.5
unnamed: R17.2, R18.1, T2.2
unnamed: C43.1, C44.1, R15.1, R17.1, R23.1, R39.2
unnamed: R23.2, R48.2, T2.5
unnamed: R38.1, T6.3
unnamed: C42.1, R18.2
unnamed: IC4.4, R19.2, R20.1, R22.2
unnamed: C42.2, IC9.14, R40.1
unnamed: IC9.8, R43.1, R73.1
unnamed: R43.2, R44.1, T6.2
unnamed: IC13.1, R59.1, R61.2
unnamed: C21.2, IC9.7, R47.2
unnamed: R61.1, R62.1, T1.5
unnamed: C10.2, IC13.7, R65.2
unnamed: IC9.5, R46.1
unnamed: R65.1, T1.1, T1.4
unnamed: R47.1, T6.1, T6.4
unnamed: IC10.12, R48.1
unnamed: IC10.13, R49.2, R58.2
unnamed: IC11.13, R50.1, R52.2
unnamed: IC11.14, R52.1, R56.1, R63.2
unnamed: IC11.9, R50.2, R51.2
unnamed: IC11.8, R51.1, R58.1, R60.2
unnamed: IC11.2, R53.2, R54.1
unnamed: IC11.1, R53.1, R67.2
unnamed: IC11.6, R54.2, R55.2
unnamed: IC11.7, R55.1, R66.2
unnamed: C32.1, C45.1, IC10.5, IC12.2, R72.1
unnamed: D4.A, IC12.7, Q2.B
unnamed: Q2.C, R68.1
unnamed: D5.A, IC9.1, Q3.B
unnamed: Q3.C, R69.1
unnamed: R13.1, R14.2, T4.2, T4.5
unnamed: R38.2, T2.1, T2.4
unnamed: R12.2, R16.1, T8.2, T8.5
unnamed: IC14.12, R70.2, R71.1
unnamed: R41.1, R73.2
unnamed: R75.1, R76.2
unnamed: R16.2, R80.1
unnamed: R42.2, R81.1
OUTPUT: C32.2, C45.2, IC12.1, R72.2, U$6.11
POLES_SWITCH: IC14.10, IC14.15, U$6.16
RESO_BAL: R79.1, U$6.9
RESO_BAL_SPLIT: IC10.14, R49.1, R56.2, R79.2
RESO_CV: D3.C, IC5.2, Q1.E, U$3.9
RESO_CV1: R76.1, U$6.7
RESO_CV_MIX: D5.C, IC9.2, Q3.E, R75.2
RESO_IABC: Q1.C, R1.1, R37.1
RESO_I_ABC: IC10.16, R69.2
SVF1_IN: IC1.1, R2.2, R3.1, R22.1
TEMP_SENSE: C9.2, IC8.2, U$3.2
TEMP_SENSE1: C34.2, IC15.2, U$6.3
TS_VDD: C11.2, IC8.1, U$3.3
TS_VDD1: C35.2, IC15.1, U$6.2
VCA_CV: D4.C, IC12.6, Q2.E, U$6.12
VCA_I_ABC: IC10.1, R68.2
VCA_NEG: IC10.4, IC14.1, IC14.3
VCA_POS: IC10.3, IC14.6, IC14.8
