xonik/xm8-panelized/(commit log)

2025-02-26 Added panelized boards for the first time
    [Bus mixer - vco - juno.brd, Bus mixer - vco - juno_top_bom.csv, Filter boards jp6 v2.0 moog v1.2.1 - v1.0.brd, Filter boards jp6 v2.0 moog v1.2.1 - v1.0_top_bom.csv, Waveshapers v2.2 for voice board v1.1.1 - v1.0.brd, Waveshapers v2.2 for voice board v1.1.1 - v1.0_top_bom.csv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]
2025-03-01 Moved and changed order
    [Xonik Waveshaper v2.3.brd, Xonik Waveshaper v2.3_top_bom.csv, Xonik Waveshaper v2.3_top_bom_populated.csv, button_breakout_v1.0.brd, button_breakout_v1.0_top_bom.csv, button_breakout_v1.0_top_bom_populated.csv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]
2025-03-01 Added Bus mixer
    [AS3364 DG412 bus mixer v1.4-4-layer.brd, AS3364 DG412 bus mixer v1.4-4-layer.sch, AS3364 DG412 bus mixer v1.4-4-layer_top_bom.csv, AS3364 DG412 bus mixer v1.4-4-layer_top_bom_populated.csv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]
2025-03-01 Order completed
    [AS3364 DG412 bus mixer v1.4-4-layer.brd, AS3364 DG412 bus mixer v1.4-4-layer.sch, AS3364 DG412 bus mixer v1.4-4-layer_top_bom.csv, AS3364 DG412 bus mixer v1.4-4-layer_top_bom_populated.csv, Xonik Waveshaper v2.3.brd, Xonik Waveshaper v2.3_top_bom.csv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]
